philspins/Atom01_hardware/README_cn.md

# ROBOTO Open Source Hardware





[English](./README.md) | **[🇨🇳 中文](#chinese-version)**

---

## 🇨🇳 Project Overview (项目概览)

This project is the core hardware repository for the **ROBOTO Bipedal Robot**. We are committed to lowering the assembly threshold by providing a complete open-source solution from mechanical structure to core circuitry.

This repository contains the following three core modules. Click the links to view detailed documentation:

### 📂 Core Modules Index (核心模组索引)

| Module Name<br>模组名称 | Function Description<br>功能描述 | Key Features<br>关键特性 | Documentation<br>文档入口 |
| :--- | :--- | :--- | :--- |
| **🤖 Robot Body**<br>机器人本体<br>(Robot Mechanical) | Mechanical structure and assembly guide<br>机械结构与总装指南 | • Step-by-step assembly tutorial<br>保姆级装配教程<br>• URDF simulation files<br>URDF 仿真文件 | [View Docs<br>查看文档](./atom01_mechnaic/README_cn.md) |
| **⚡ Power Distribution Board**<br>电源分配板<br>(Power Distribution) | Core power supply hub<br>核心供电枢纽 | • 48V high voltage input<br>48V 高压输入<br>• XT30/XT60 interface<br>XT30/XT60 接口<br>• Centralized power architecture<br>集中式供电架构 | [View Docs<br>查看文档](./atom01_pcb/Roboto_Power/README_cn.md) |
| **📡 Communication Module**<br>通讯模块<br>(USB-to-CAN) | Signal conversion gateway<br>信号转换网关 | • USB to 4-channel CAN<br>USB 转 4路 CAN<br>• Linux dedicated<br>Linux 专用<br>• 120Ω terminal matching<br>120Ω 终端匹配 | [View Docs<br>查看文档](./atom01_pcb/Roboto_Usb2Can/README_cn.md) |
---
