philspins/Atom01_hardware/atom01_mechnaic/01_SW_Project/Foot_Sole_Rubber_Assembly.SLDASM

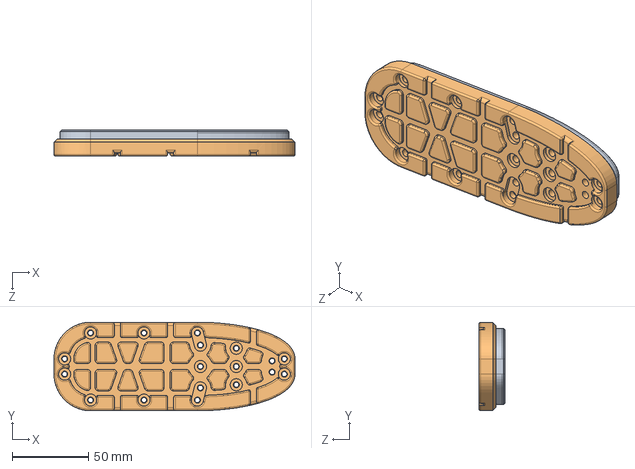
[picture p1: CAD file, 2026-02-06]
atom01_mechnaic/01_SW_Project/Foot_Sole_Rubber_Assembly.SLDASM
158.0 x 58.0 x 17.0 mm
脚底板
橡胶脚底
