philspins/Atom01_hardware/atom01_mechnaic/01_SW_Project/Foot_Assembly.SLDASM

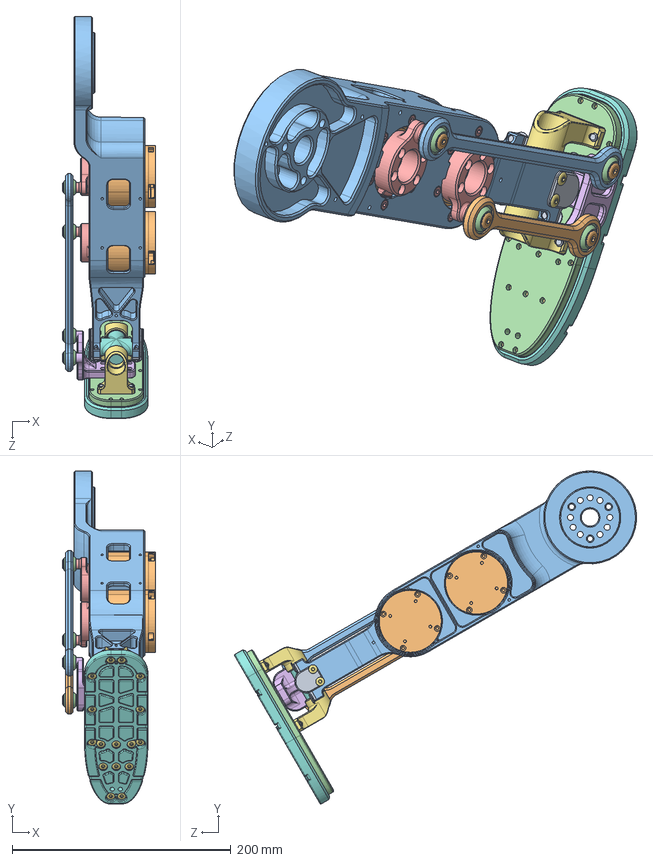
[picture p2: CAD file, 2026-02-06]
atom01_mechnaic/01_SW_Project/Foot_Assembly.SLDASM
85.0 x 304.7 x 367.8 mm
GB╱T 70.1-2008[内六角圆柱头螺钉M5×10].step x 10
短连杆
长连杆
镜向GB╱T 9163-2001[向心关节轴承（G系列）8] x 4
输出法兰连杆 x 2
脚底连杆
脚踝横滚连接件 x 2
镜向16x40十字轴承
小腿轴承锁 x 2
DM 4340 rau 3505 电机 3D x 2
小腿
脚底板
GB╱T 70.1-2008[内六角圆柱头螺钉M3×8].step x 12
GB╱T 70.1-2008[内六角圆柱头螺钉M3×12].step x 10
平头M4x10螺丝 x 20
橡胶脚底
平头M5x10螺丝 x 4
平头M5x16螺丝 x 4
