philspins/Atom01_hardware/atom01_mechnaic/01_SW_Project/GB_T_4605-2003[Thrust_Needle_Roller_and_Cage_Assembly_AXK6085].sldprt

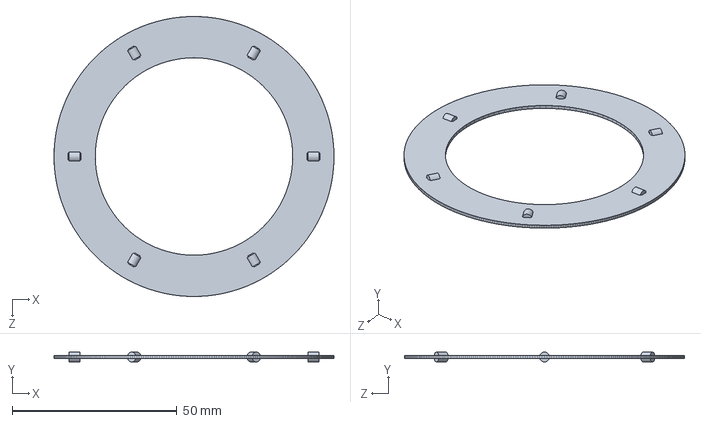
[picture p3: CAD file, 2026-02-06]
atom01_mechnaic/01_SW_Project/GB_T_4605-2003[Thrust_Needle_Roller_and_Cage_Assembly_AXK6085].sldprt
85.0 x 3.00 x 85.0 mm
