philspins/Atom01_hardware/atom01_mechnaic/01_SW_Project/01_Calibration_Parts/Foot_Calibration_Part_Qty1.STEP

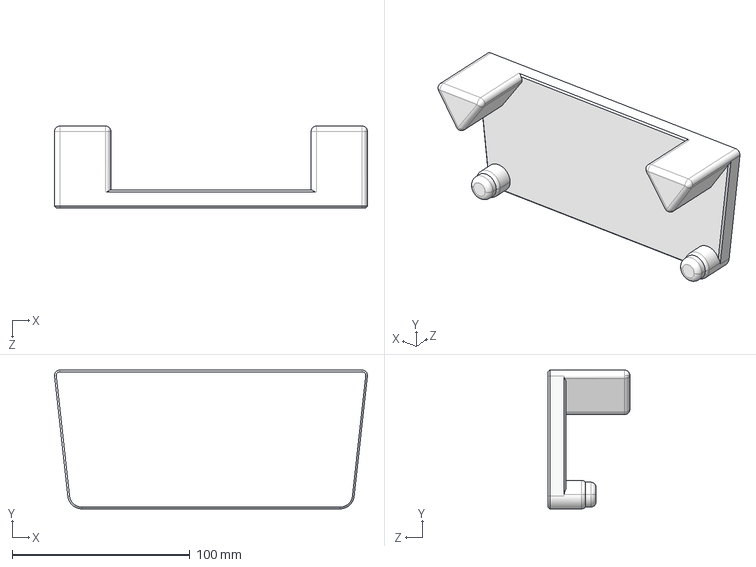
[picture p4: CAD file, 2026-02-06]
atom01_mechnaic/01_SW_Project/01_Calibration_Parts/Foot_Calibration_Part_Qty1.STEP
175.9 x 78.0 x 46.0 mm
