philspins/Atom01_hardware/atom01_mechnaic/01_SW_Project/20cm_Foot/20cm_Foot.STEP

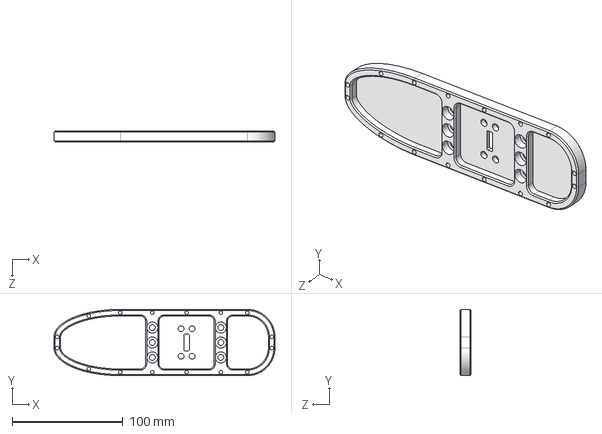
[picture p5: CAD file, 2026-02-06]
atom01_mechnaic/01_SW_Project/20cm_Foot/20cm_Foot.STEP
200.0 x 60.0 x 10.0 mm
