philspins/Atom01_hardware/atom01_mechnaic/01_SW_Project/Battery/Battery_Box_Rough_Dimensions.stp

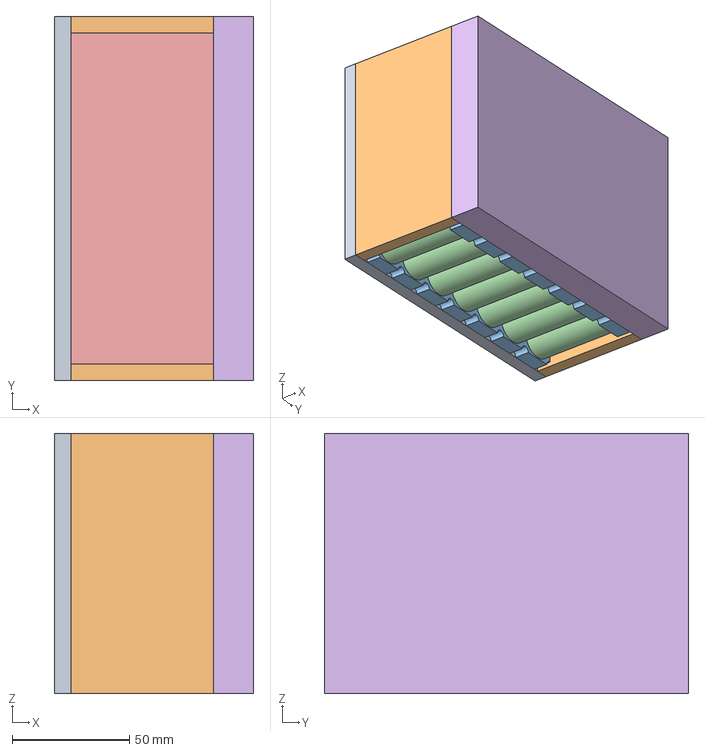
[picture p6: CAD file, 2026-02-06]
atom01_mechnaic/01_SW_Project/Battery/Battery_Box_Rough_Dimensions.stp
85.0 x 155.4 x 111.0 mm
