philspins/Atom01_hardware/atom01_mechnaic/01_SW_Project/Rubber_Foot_Sole/Rubber_Foot_Sole.STEP

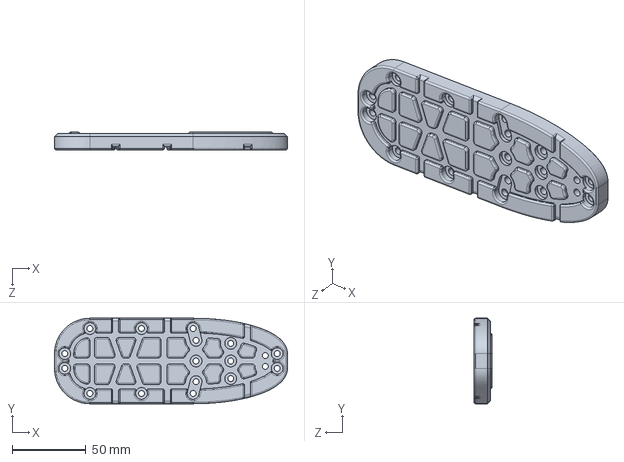
[picture p7: CAD file, 2026-02-06]
atom01_mechnaic/01_SW_Project/Rubber_Foot_Sole/Rubber_Foot_Sole.STEP
158.0 x 58.0 x 12.0 mm
