philspins/Atom01_hardware/atom01_mechnaic/01_SW_Project/Shell_Modified_Parts_1/Shell_Modified_Parts/Chest_Shoulder.stp

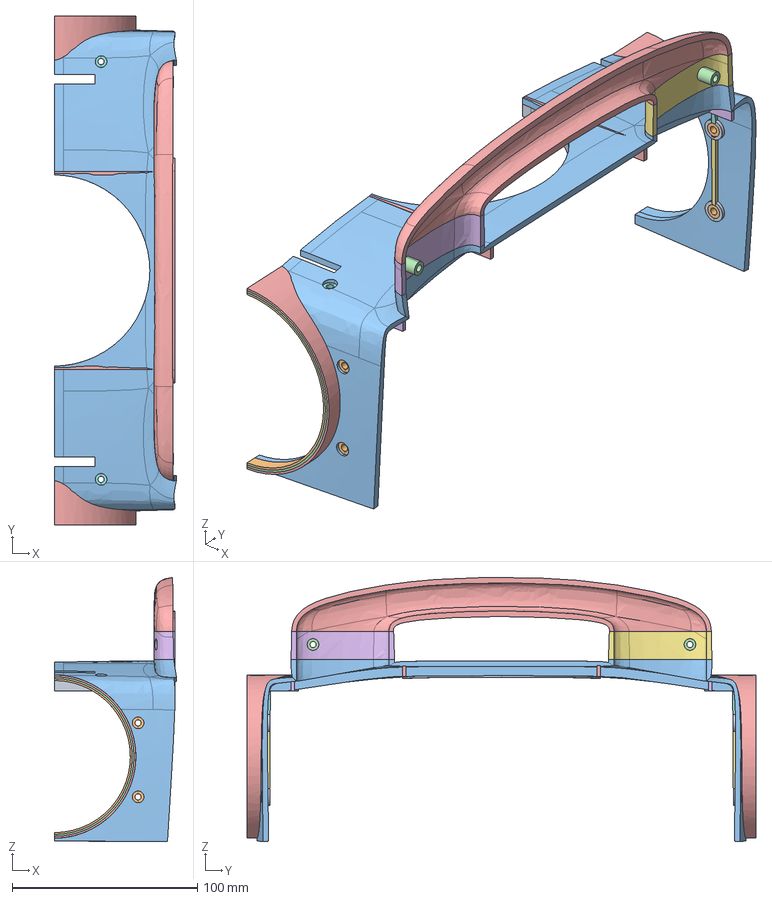
[picture p8: CAD file, 2026-02-06]
atom01_mechnaic/01_SW_Project/Shell_Modified_Parts_1/Shell_Modified_Parts/Chest_Shoulder.stp
66.2 x 275.1 x 142.7 mm
