philspins/Atom01_hardware/atom01_mechnaic/01_SW_Project/Shoulder_Mounting_Part.SLDPRT

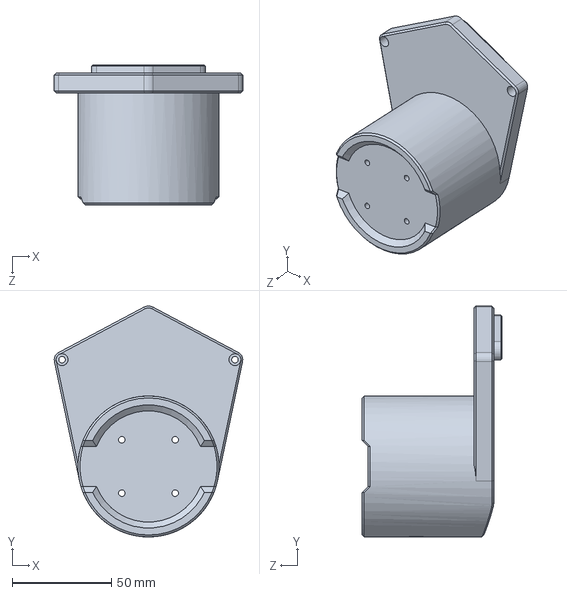
[picture p9: CAD file, 2026-02-06]
atom01_mechnaic/01_SW_Project/Shoulder_Mounting_Part.SLDPRT
95.0 x 116.3 x 70.2 mm
