philspins/Atom01_hardware/atom01_mechnaic/01_SW_Project/Soft_Rubber_Lower_Body/软胶 下身/Soft_Rubber_Lower_Leg_Rear_Left.stl

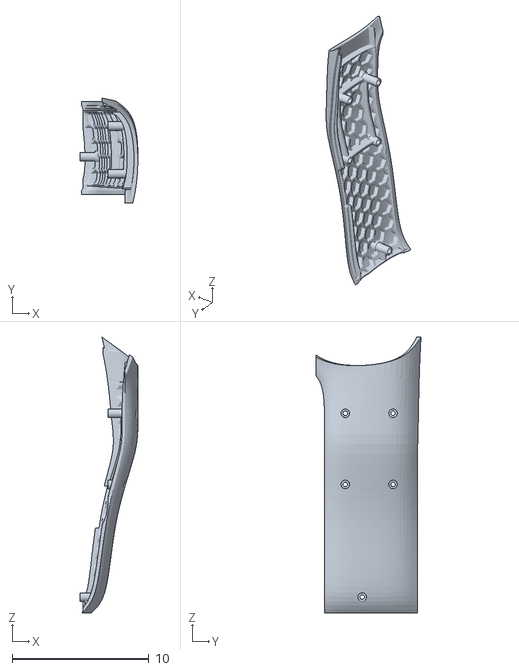
[picture p10: CAD file, 2026-02-06]
atom01_mechnaic/01_SW_Project/Soft_Rubber_Lower_Body/软胶 下身/Soft_Rubber_Lower_Leg_Rear_Left.stl
4.23 x 7.66 x 20.2
