philspins/Atom01_hardware/atom01_mechnaic/02_Manufacturing/3D_Printing/Waist_Calibration_Part_Qty1.STEP

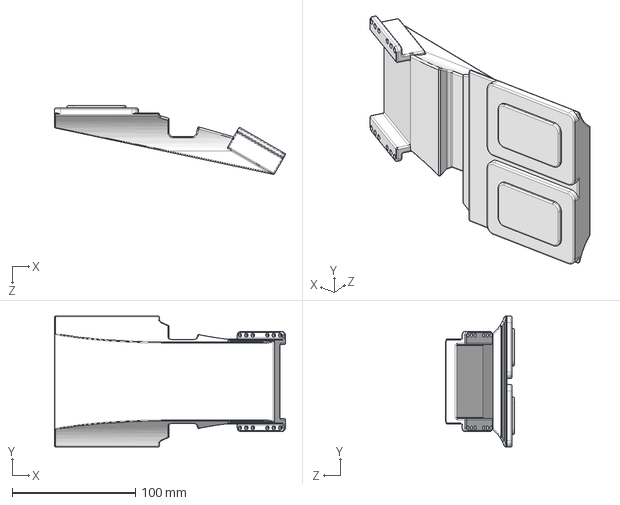
[picture p11: CAD file, 2026-02-06]
atom01_mechnaic/02_Manufacturing/3D_Printing/Waist_Calibration_Part_Qty1.STEP
187.2 x 106.0 x 55.7 mm
