philspins/Atom01_hardware/atom01_mechnaic/02_Manufacturing/CNC_Machining/Hip_Clamp_Plate.STEP

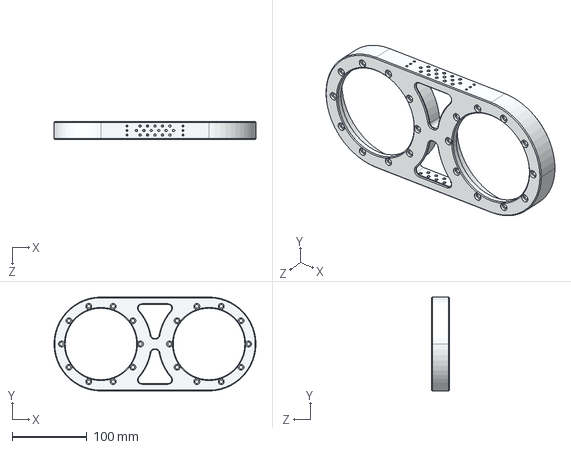
[picture p12: CAD file, 2026-02-06]
atom01_mechnaic/02_Manufacturing/CNC_Machining/Hip_Clamp_Plate.STEP
271.0 x 126.0 x 24.0 mm
