philspins/Atom01_hardware/atom01_mechnaic/atom-bom/SW模型/外壳修改部件(1)/外壳修改部件/腰部下册.stp

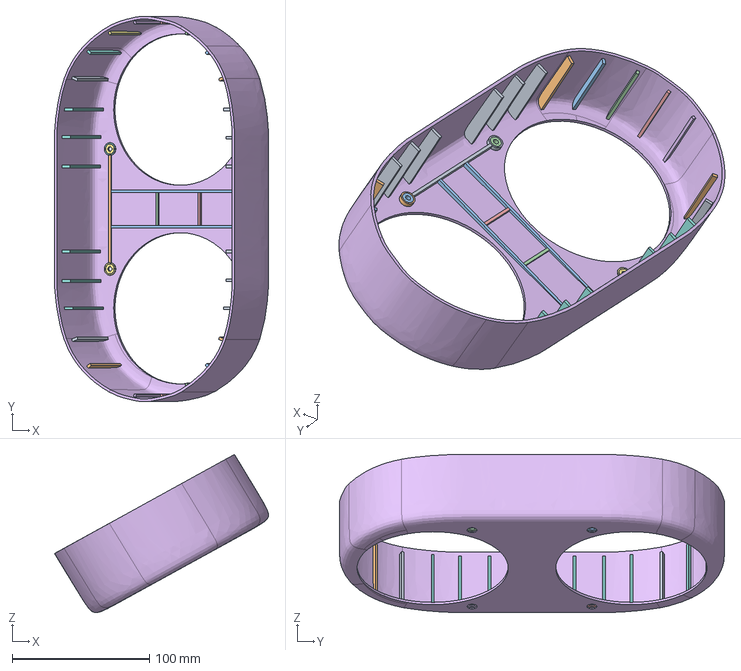
[picture p13: CAD file, 2025-05-23]
atom01_mechnaic/atom-bom/SW模型/外壳修改部件(1)/外壳修改部件/腰部下册.stp
156.1 x 281.2 x 115.4 mm
