philspins/Atom01_hardware/atom01_mechnaic/atom-bom/SW模型/通用连接件扩孔法兰.SLDPRT

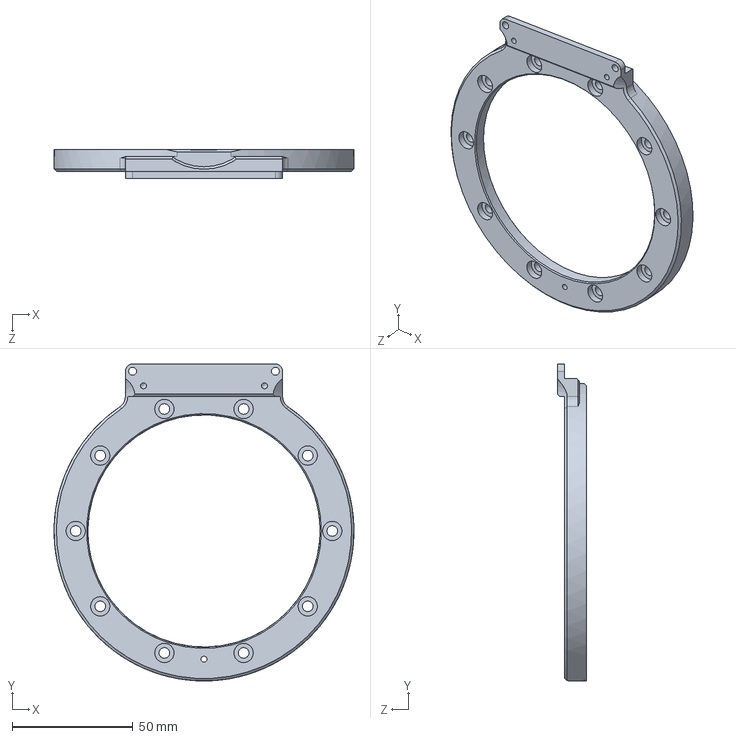
[picture p14: CAD file, 2025-05-23]
atom01_mechnaic/atom-bom/SW模型/通用连接件扩孔法兰.SLDPRT
123.9 x 131.0 x 12.0 mm
