philspins/Atom01_hardware/atom01_mechnaic/01_SW_Project/01_Calibration_Parts/Thigh_Rear_Calibration_Qty1.STEP

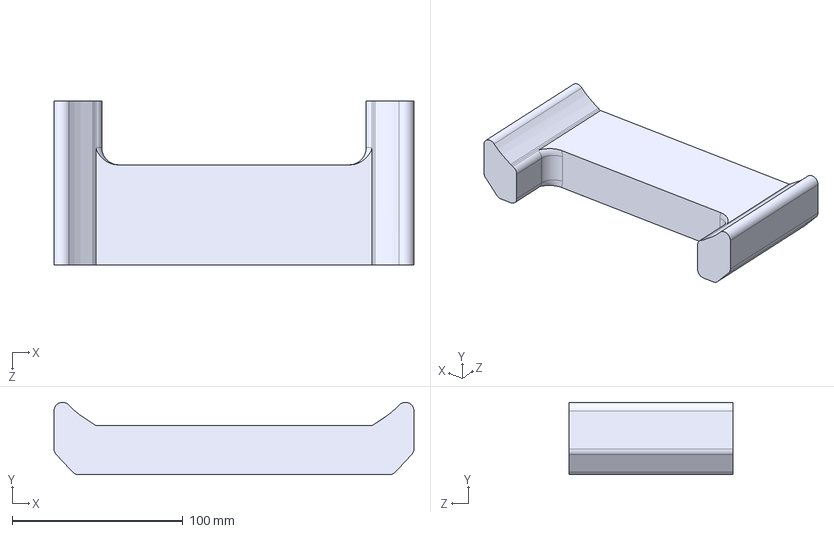
[picture p16: CAD file, 2026-02-06]
atom01_mechnaic/01_SW_Project/01_Calibration_Parts/Thigh_Rear_Calibration_Qty1.STEP
210.7 x 42.4 x 96.0 mm
