philspins/Atom01_hardware/atom01_mechnaic/01_SW_Project/Long_Link.STEP

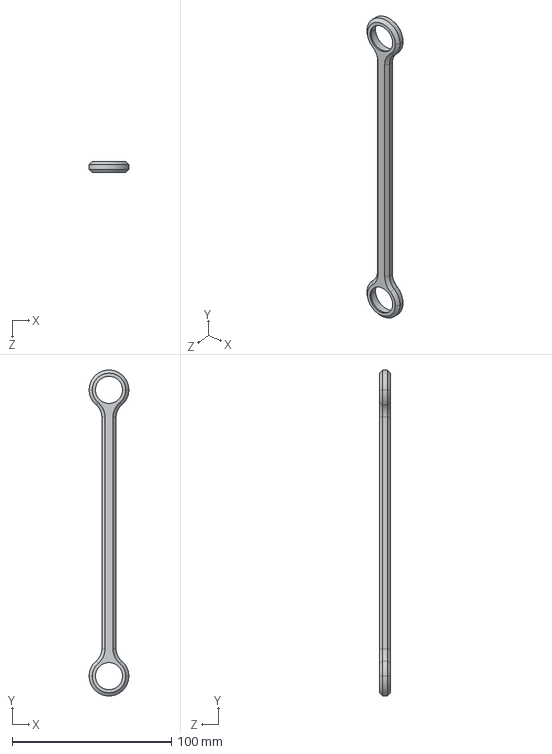
[picture p17: CAD file, 2026-02-06]
atom01_mechnaic/01_SW_Project/Long_Link.STEP
25.0 x 205.0 x 7.00 mm
