philspins/Atom01_hardware/atom01_mechnaic/01_SW_Project/Shell_Modified_Parts_1/Shell_Modified_Parts/Thigh_Root_Structure_Hole.stp

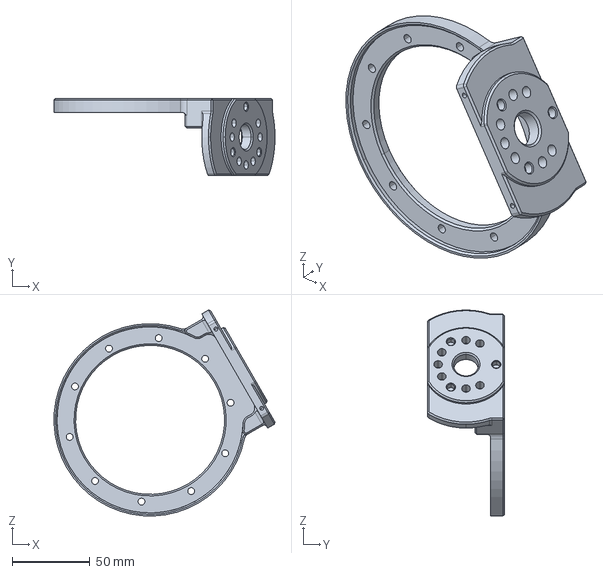
[picture p18: CAD file, 2026-02-06]
atom01_mechnaic/01_SW_Project/Shell_Modified_Parts_1/Shell_Modified_Parts/Thigh_Root_Structure_Hole.stp
142.5 x 49.7 x 132.8 mm
