philspins/Atom01_hardware/atom01_mechnaic/01_SW_Project/Soft_Rubber_Lower_Body/软胶 下身/Soft_Rubber_Thigh_Root_Left.stl

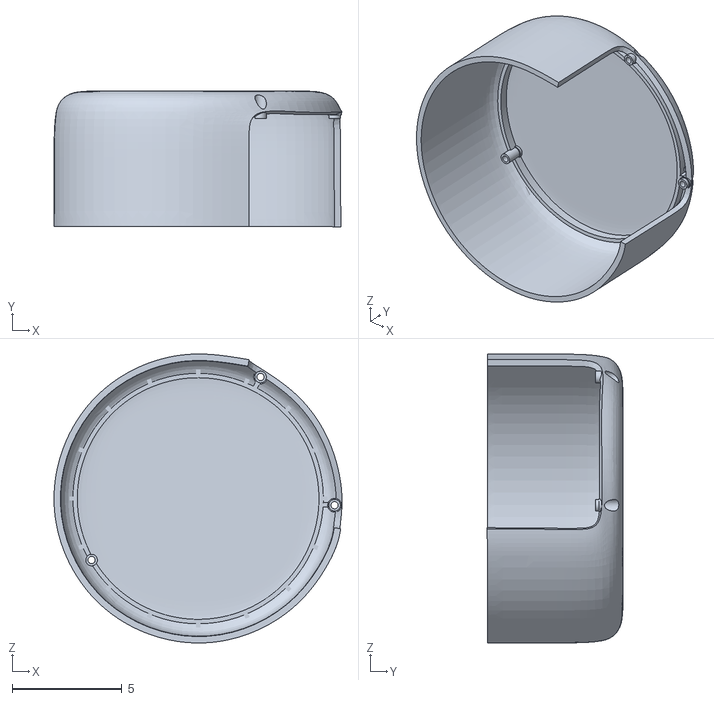
[picture p19: CAD file, 2026-02-06]
atom01_mechnaic/01_SW_Project/Soft_Rubber_Lower_Body/软胶 下身/Soft_Rubber_Thigh_Root_Left.stl
13.1 x 6.21 x 13.2
