philspins/Atom01_hardware/atom01_mechnaic/02_Manufacturing/3D_Printing/Thigh_Positioning_Block_Qty2.STEP

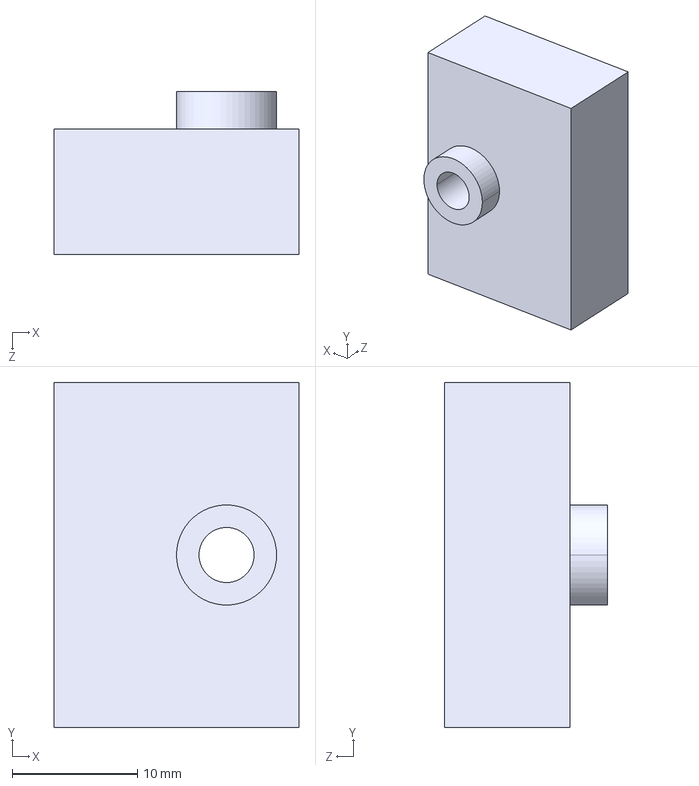
[picture p20: CAD file, 2026-02-06]
atom01_mechnaic/02_Manufacturing/3D_Printing/Thigh_Positioning_Block_Qty2.STEP
19.6 x 27.6 x 13.0 mm
