philspins/Atom01_hardware/atom01_mechnaic/02_Manufacturing/CNC_Machining/Hip_Joint_Mounting.STEP

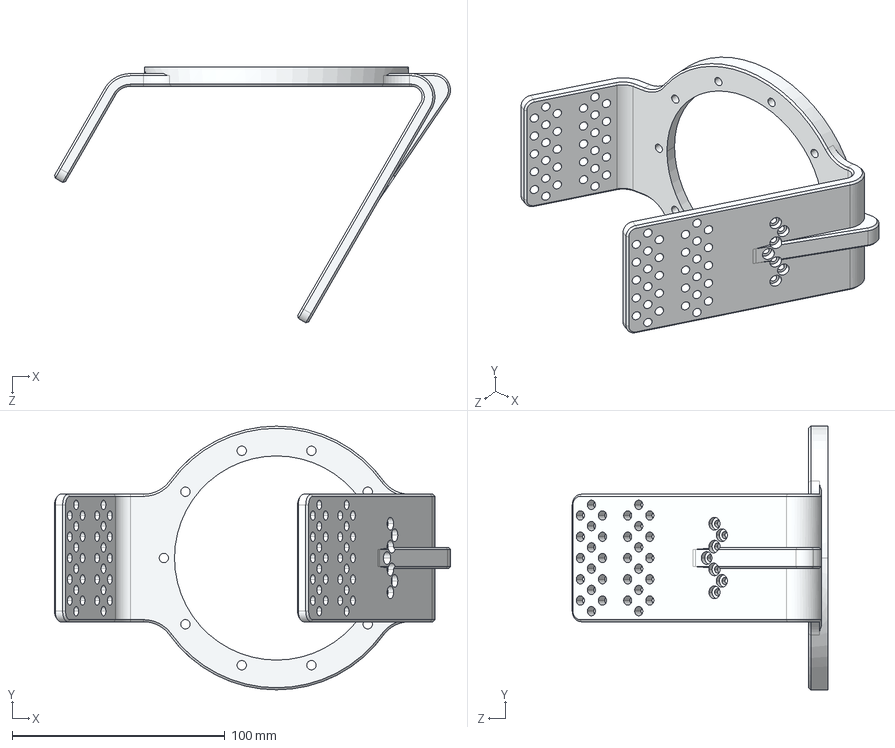
[picture p21: CAD file, 2026-02-06]
atom01_mechnaic/02_Manufacturing/CNC_Machining/Hip_Joint_Mounting.STEP
186.2 x 124.0 x 120.2 mm
