philspins/Atom01_hardware/atom01_mechnaic/atom-bom/SW模型/通用连接件.SLDPRT

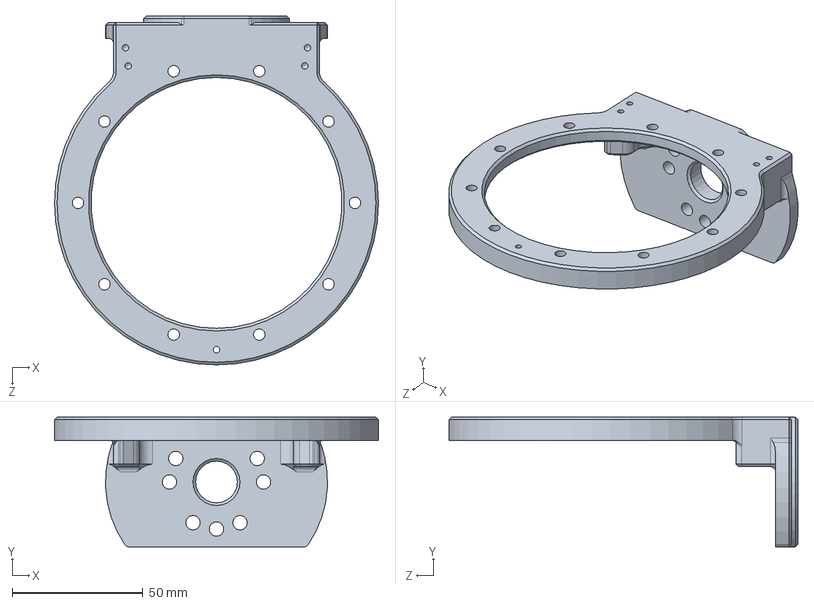
[picture p22: CAD file, 2025-05-23]
atom01_mechnaic/atom-bom/SW模型/通用连接件.SLDPRT
124.0 x 49.7 x 133.5 mm
