philspins/Atom01_hardware/atom01_mechnaic/01_SW_Project/Lower_Leg_Bearing_Lock.STEP

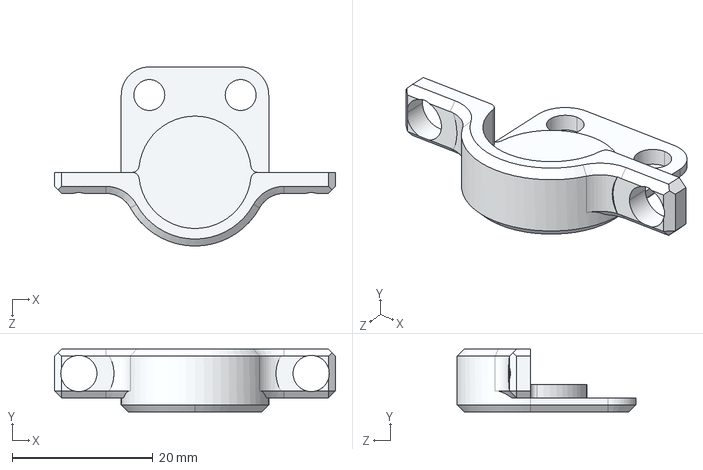
[picture p23: CAD file, 2026-02-06]
atom01_mechnaic/01_SW_Project/Lower_Leg_Bearing_Lock.STEP
40.0 x 8.93 x 25.5 mm
