philspins/Atom01_hardware/atom01_mechnaic/01_SW_Project/Soft_Rubber_Lower_Body/软胶 下身/Soft_Rubber_Waist_Lower.stl

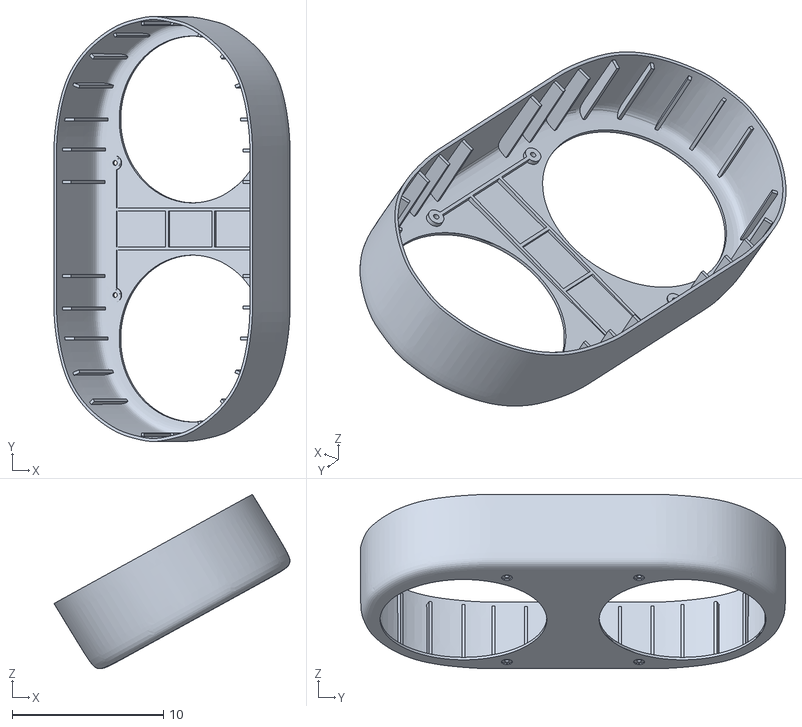
[picture p24: CAD file, 2026-02-06]
atom01_mechnaic/01_SW_Project/Soft_Rubber_Lower_Body/软胶 下身/Soft_Rubber_Waist_Lower.stl
15.6 x 28.1 x 11.5
