philspins/Atom01_hardware/atom01_mechnaic/02_Manufacturing/3D_Printing/PCB_Carrier_Board.STEP

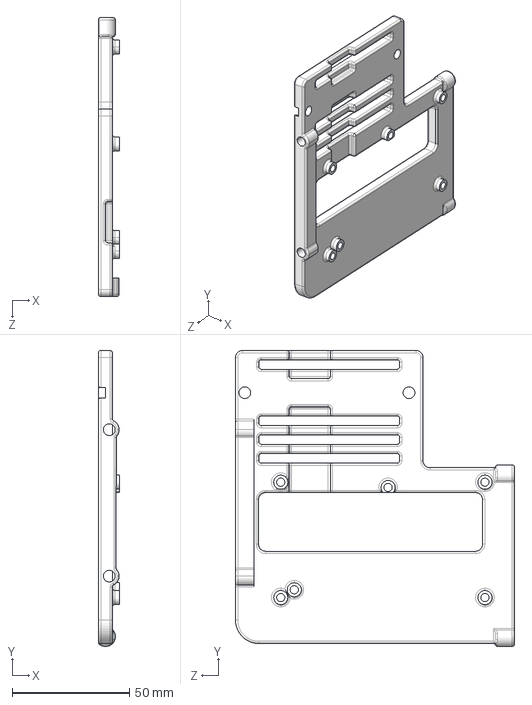
[picture p25: CAD file, 2026-02-06]
atom01_mechnaic/02_Manufacturing/3D_Printing/PCB_Carrier_Board.STEP
9.00 x 126.2 x 119.0 mm
