philspins/Atom01_hardware/atom01_mechnaic/02_Manufacturing/CNC_Machining/atom_arm_copy_3.STEP

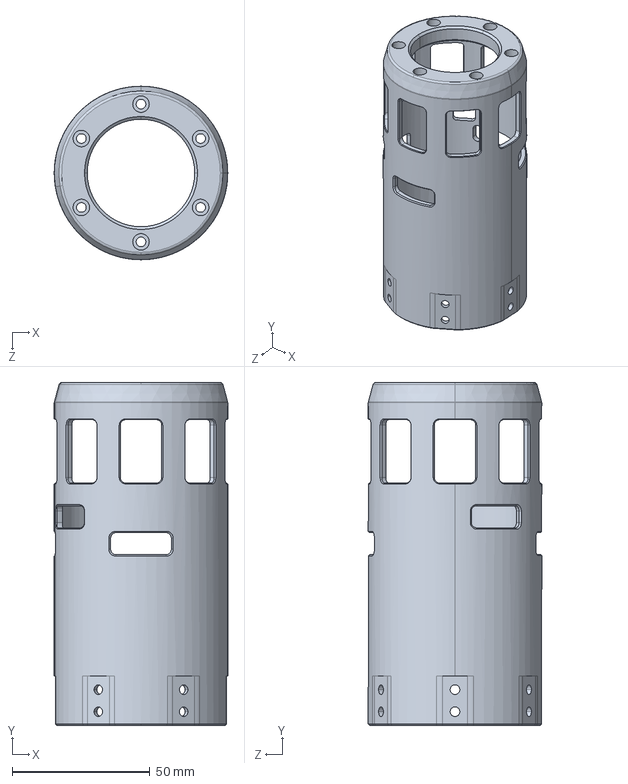
[picture p26: CAD file, 2026-02-06]
atom01_mechnaic/02_Manufacturing/CNC_Machining/atom_arm_copy_3.STEP
63.0 x 124.5 x 63.0 mm
