philspins/Atom01_hardware/atom01_mechnaic/atom-bom/SW模型/髋夹板.SLDPRT

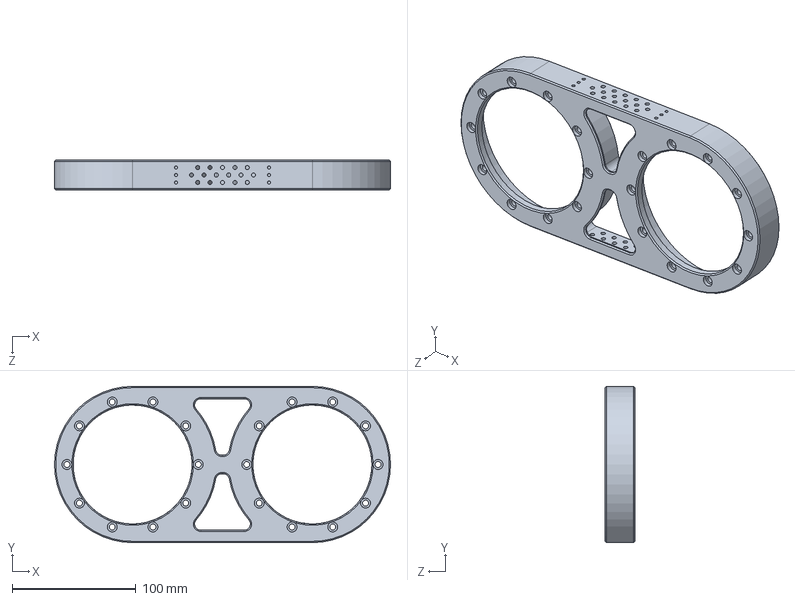
[picture p27: CAD file, 2025-05-23]
atom01_mechnaic/atom-bom/SW模型/髋夹板.SLDPRT
271.0 x 126.0 x 24.0 mm
