philspins/Atom01_hardware/atom01_mechnaic/01_SW_Project/Soft_Rubber_Lower_Body/软胶 下身/Soft_Rubber_Lower_Leg_Knee_Left.stl

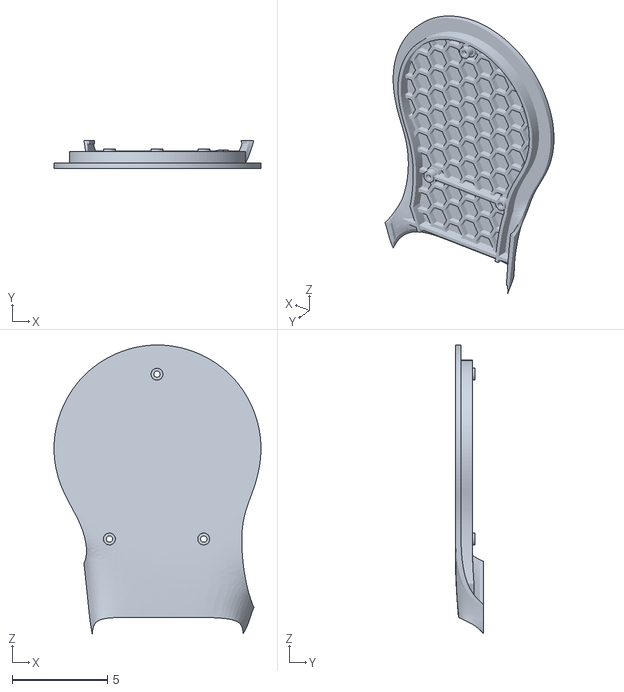
[picture p28: CAD file, 2026-02-06]
atom01_mechnaic/01_SW_Project/Soft_Rubber_Lower_Body/软胶 下身/Soft_Rubber_Lower_Leg_Knee_Left.stl
10.9 x 1.49 x 15.2
