philspins/Atom01_hardware/atom01_mechnaic/02_Manufacturing/3D_Printing/Knee_Calibration_Qty2.STEP

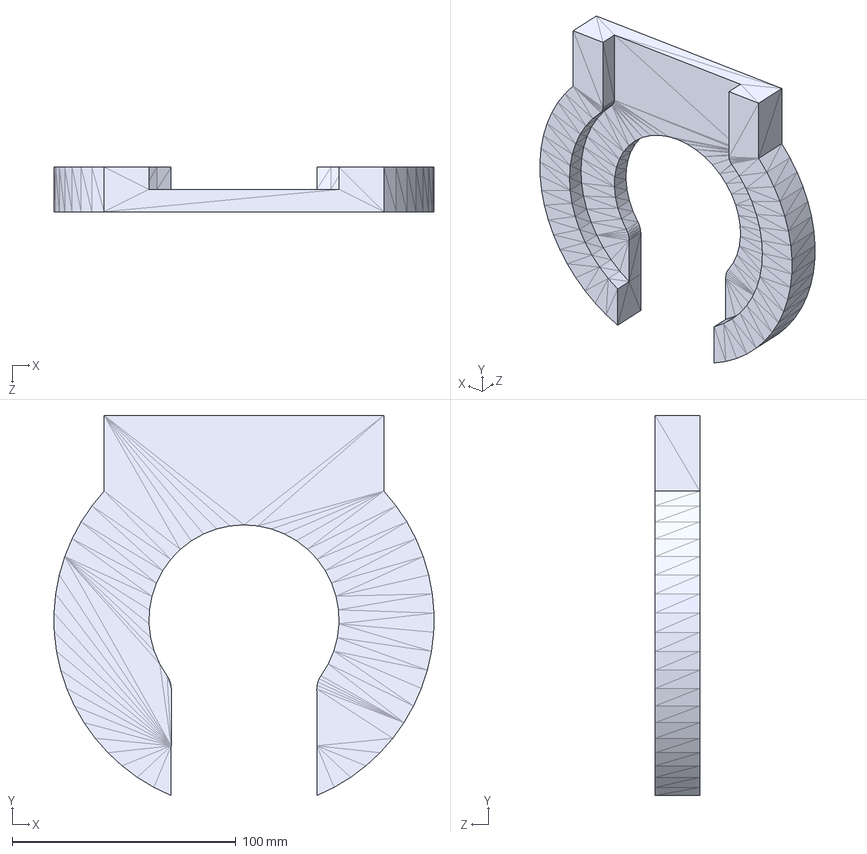
[picture p29: CAD file, 2026-02-06]
atom01_mechnaic/02_Manufacturing/3D_Printing/Knee_Calibration_Qty2.STEP
169.9 x 170.0 x 19.9 mm
