philspins/Atom01_hardware/atom01_mechnaic/02_Manufacturing/CNC_Machining/IMU_Carrier_Board.STEP

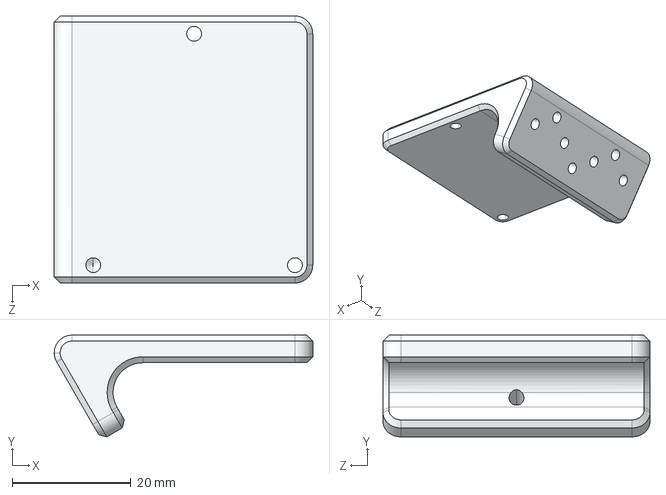
[picture p30: CAD file, 2026-02-06]
atom01_mechnaic/02_Manufacturing/CNC_Machining/IMU_Carrier_Board.STEP
43.6 x 17.1 x 45.0 mm
