philspins/Atom01_hardware/atom01_mechnaic/01_SW_Project/Soft_Rubber_Lower_Body/软胶 下身/Soft_Rubber_Thigh_Rear_Left.stl

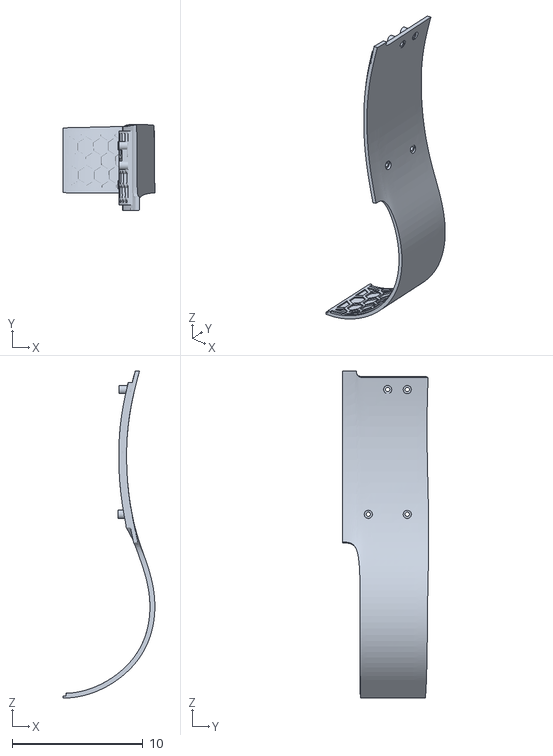
[picture p31: CAD file, 2026-02-06]
atom01_mechnaic/01_SW_Project/Soft_Rubber_Lower_Body/软胶 下身/Soft_Rubber_Thigh_Rear_Left.stl
7.01 x 6.61 x 25.0
