philspins/Atom01_hardware/atom01_mechnaic/01_SW_Project/Upper_Arm_Root_Front.stp

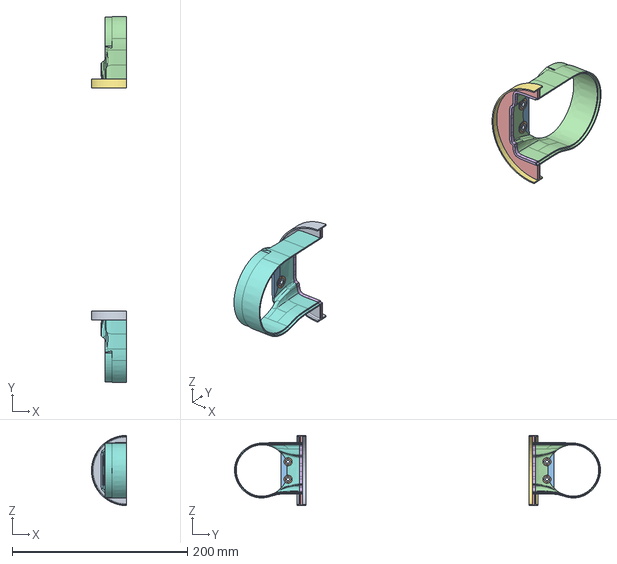
[picture p32: CAD file, 2026-02-06]
atom01_mechnaic/01_SW_Project/Upper_Arm_Root_Front.stp
40.1 x 417.7 x 80.2 mm
