philspins/Atom01_hardware/atom01_mechnaic/02_Manufacturing/3D_Printing/Ankle_Calibration_Qty2.STEP

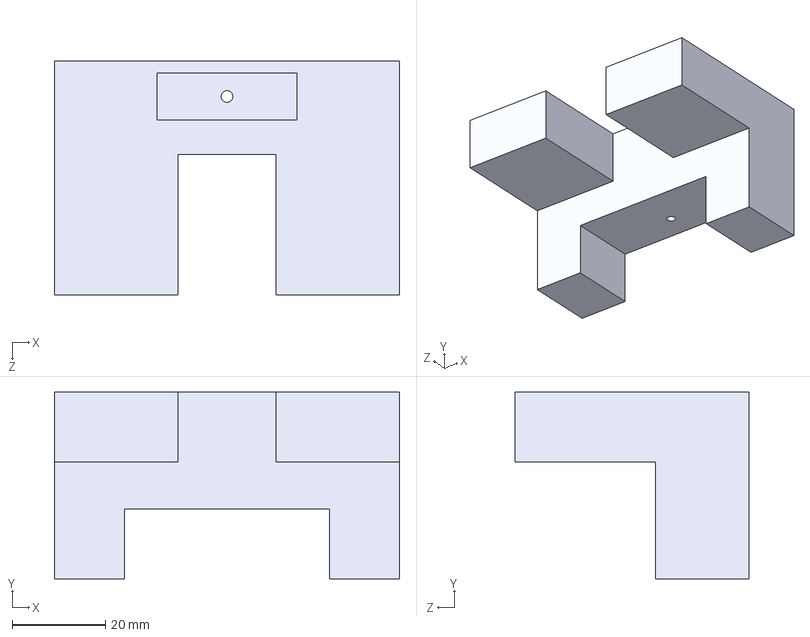
[picture p35: CAD file, 2026-02-06]
atom01_mechnaic/02_Manufacturing/3D_Printing/Ankle_Calibration_Qty2.STEP
73.9 x 40.0 x 50.0 mm
