philspins/Atom01_hardware/atom01_mechnaic/02_Manufacturing/CNC_Machining/atom_arm_copy_4.STEP

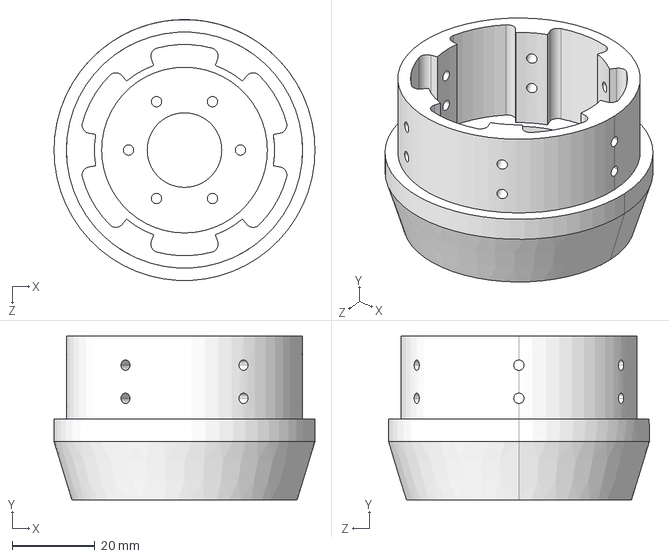
[picture p36: CAD file, 2026-02-06]
atom01_mechnaic/02_Manufacturing/CNC_Machining/atom_arm_copy_4.STEP
63.0 x 39.5 x 63.0 mm
