philspins/Atom01_hardware/atom01_mechnaic/01_SW_Project/Chest_Rear_Clamp_Plate.STEP

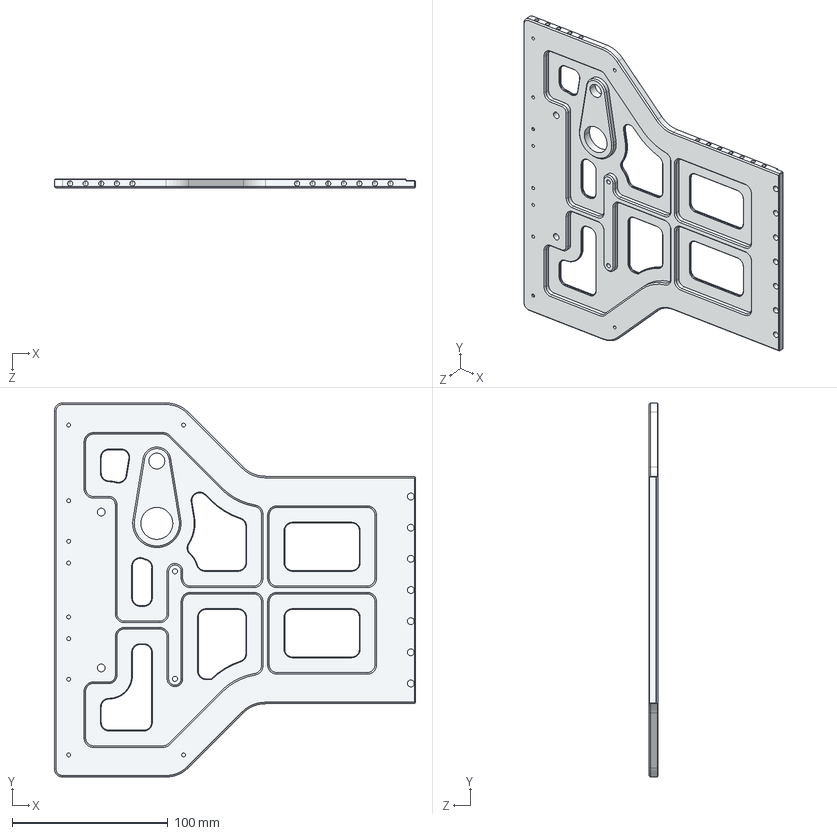
[picture p37: CAD file, 2026-02-06]
atom01_mechnaic/01_SW_Project/Chest_Rear_Clamp_Plate.STEP
231.7 x 240.0 x 6.00 mm
