philspins/Atom01_hardware/atom01_mechnaic/02_Manufacturing/CNC_Machining/Ankle_Roll_Connector.STEP

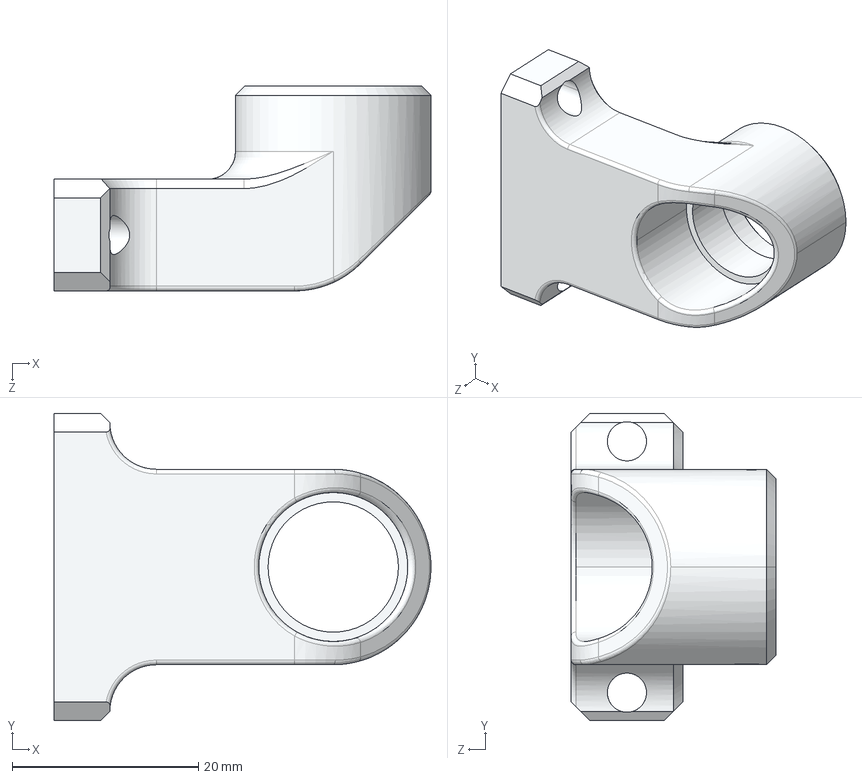
[picture p39: CAD file, 2026-02-06]
atom01_mechnaic/02_Manufacturing/CNC_Machining/Ankle_Roll_Connector.STEP
40.5 x 33.0 x 22.0 mm
