philspins/Atom01_hardware/atom01_mechnaic/01_SW_Project/01_Calibration_Parts/Elbow_Calibration_Part_Qty2.STEP

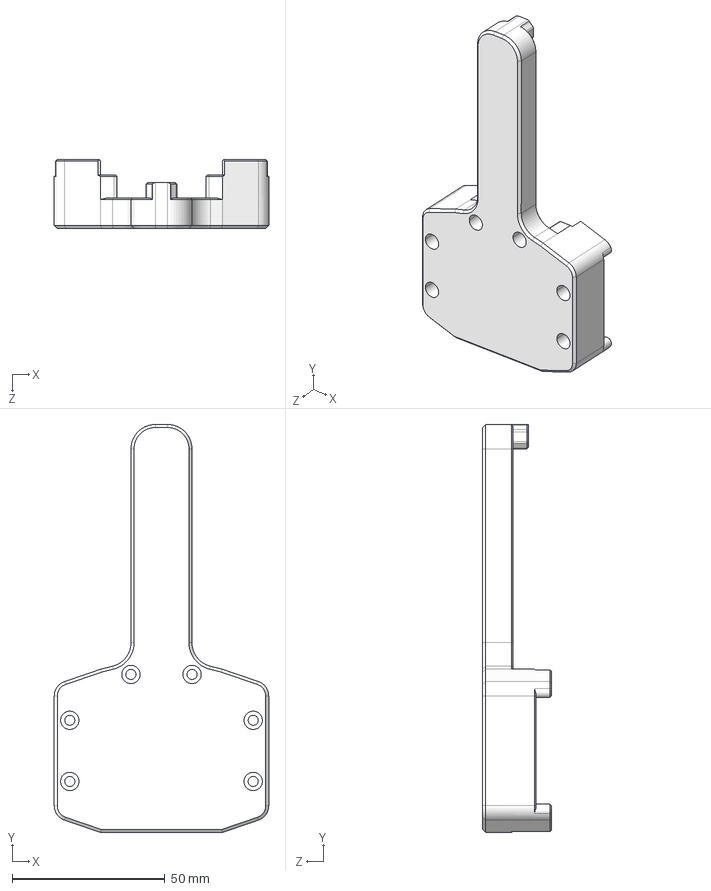
[picture p40: CAD file, 2026-02-06]
atom01_mechnaic/01_SW_Project/01_Calibration_Parts/Elbow_Calibration_Part_Qty2.STEP
70.2 x 133.4 x 22.6 mm
