philspins/Atom01_hardware/atom01_mechnaic/02_Manufacturing/CNC_Machining/Foot_Sole_Plate.STEP

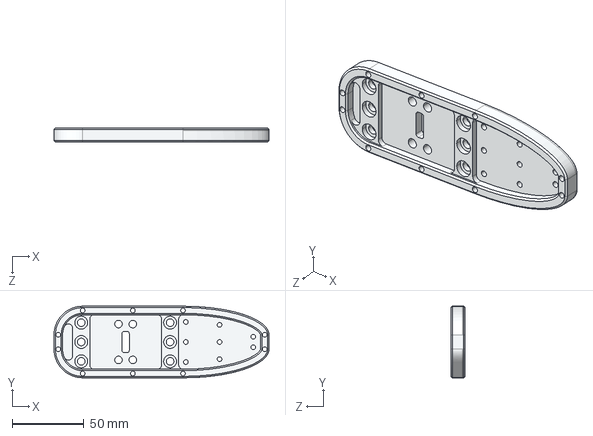
[picture p43: CAD file, 2026-02-06]
atom01_mechnaic/02_Manufacturing/CNC_Machining/Foot_Sole_Plate.STEP
150.0 x 50.0 x 10.0 mm
