philspins/Atom01_hardware/atom01_mechnaic/01_SW_Project/Right_Hand.SLDPRT

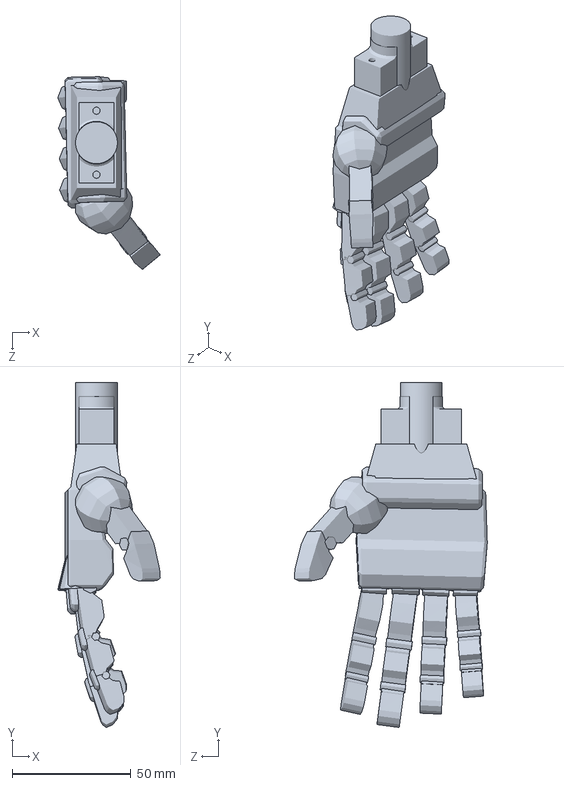
[picture p45: CAD file, 2026-02-06]
atom01_mechnaic/01_SW_Project/Right_Hand.SLDPRT
43.2 x 145.5 x 81.3 mm
