philspins/Atom01_hardware/atom01_mechnaic/02_Manufacturing/CNC_Machining/Waist_Support.STEP

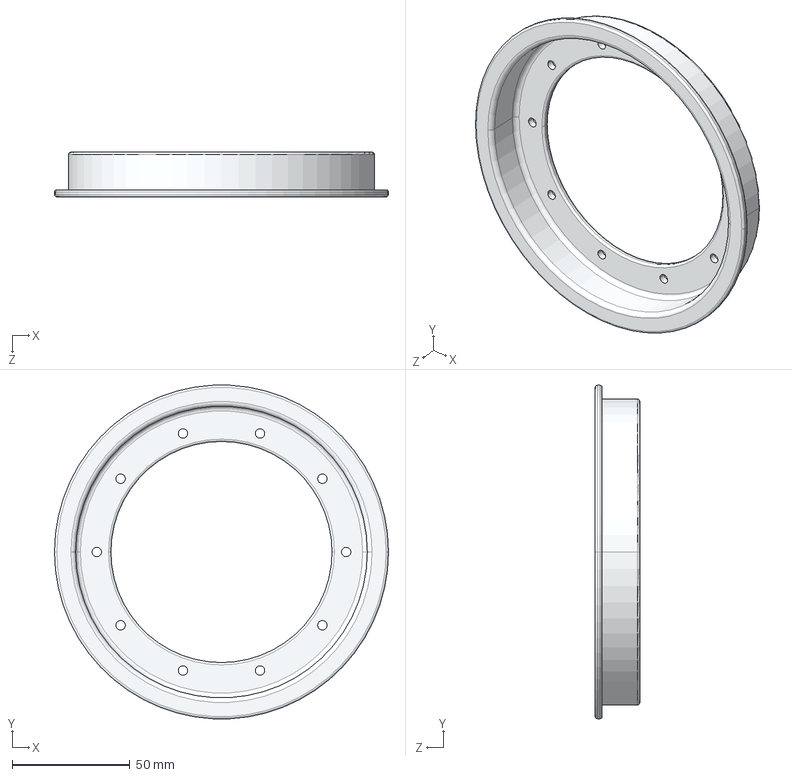
[picture p46: CAD file, 2026-02-06]
atom01_mechnaic/02_Manufacturing/CNC_Machining/Waist_Support.STEP
142.0 x 141.8 x 19.0 mm
