philspins/Atom01_hardware/atom01_mechnaic/01_SW_Project/48V_to_5V.SLDPRT

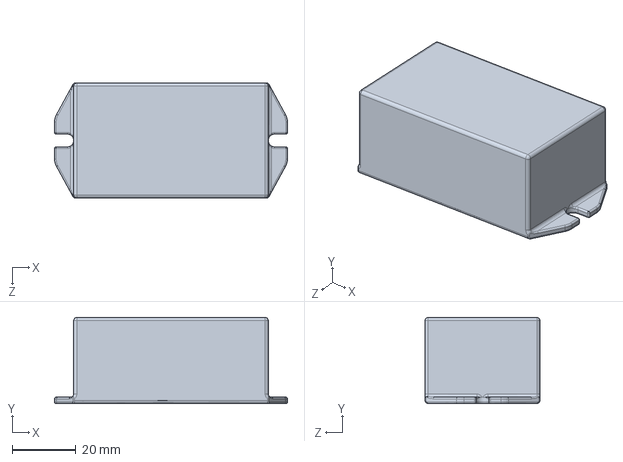
[picture p47: CAD file, 2026-02-06]
atom01_mechnaic/01_SW_Project/48V_to_5V.SLDPRT
73.0 x 27.0 x 36.0 mm
