philspins/Atom01_hardware/atom01_mechnaic/02_Manufacturing/CNC_Machining/atom_arm_copy_2.STEP

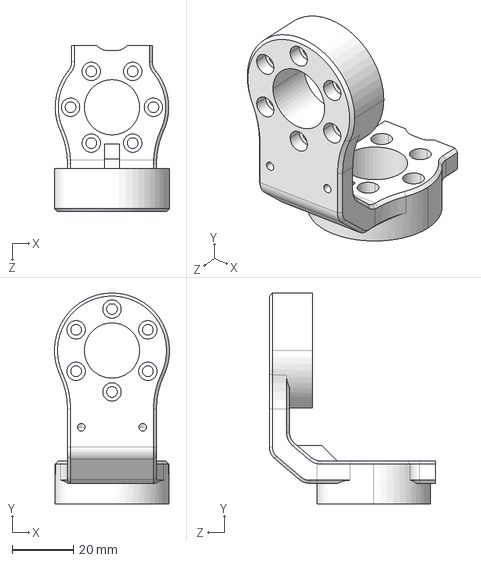
[picture p48: CAD file, 2026-02-06]
atom01_mechnaic/02_Manufacturing/CNC_Machining/atom_arm_copy_2.STEP
37.5 x 68.7 x 54.2 mm
