philspins/Atom01_hardware/atom01_mechnaic/02_Manufacturing/CNC_Machining/Limit_Pin.STEP

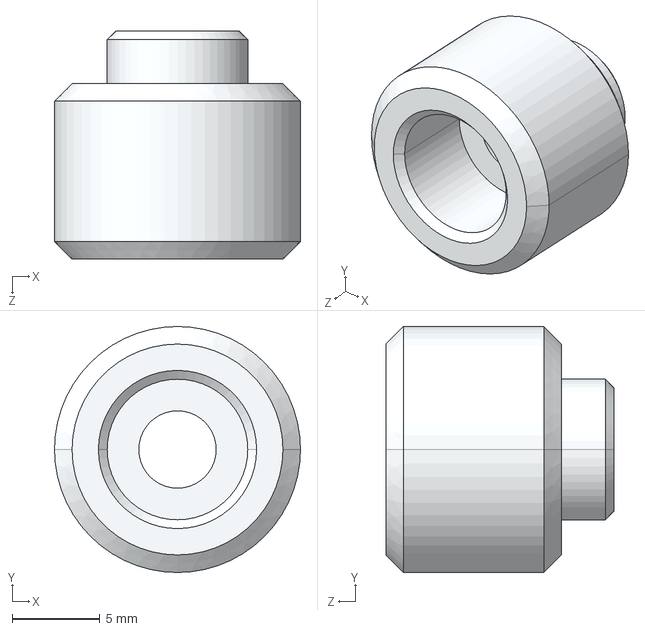
[picture p50: CAD file, 2026-02-06]
atom01_mechnaic/02_Manufacturing/CNC_Machining/Limit_Pin.STEP
14.0 x 14.0 x 13.0 mm
