philspins/Atom01_hardware/atom01_mechnaic/02_Manufacturing/CNC_Machining/Side_Plate_Cross_Plate.STEP

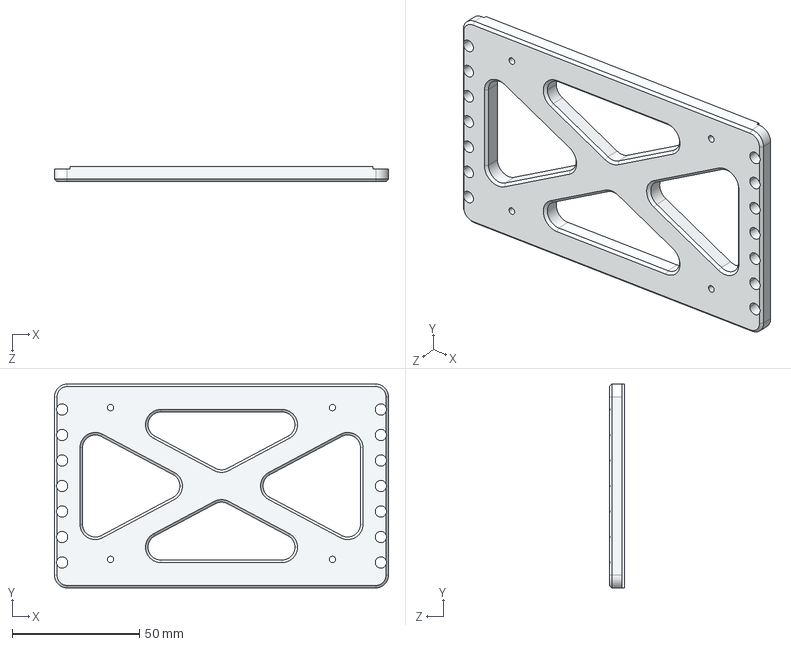
[picture p51: CAD file, 2026-02-06]
atom01_mechnaic/02_Manufacturing/CNC_Machining/Side_Plate_Cross_Plate.STEP
131.0 x 80.0 x 6.00 mm
