philspins/Atom01_hardware/atom01_mechnaic/01_SW_Project/Hand_Spherical.stp

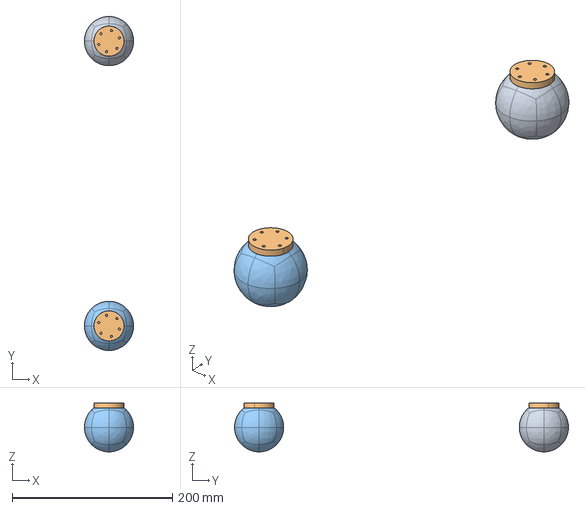
[picture p52: CAD file, 2026-02-06]
atom01_mechnaic/01_SW_Project/Hand_Spherical.stp
61.4 x 416.9 x 60.9 mm
