philspins/Atom01_hardware/atom01_mechnaic/01_SW_Project/PCB_Carrier_Board.STEP

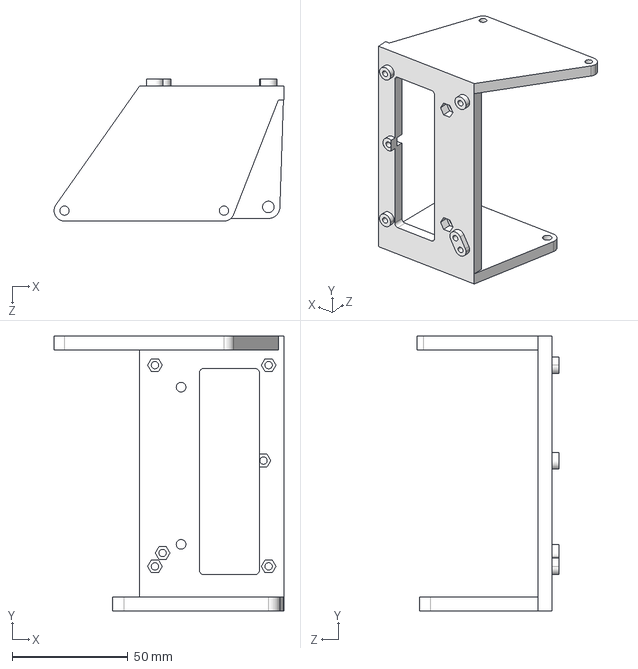
[picture p54: CAD file, 2026-02-06]
atom01_mechnaic/01_SW_Project/PCB_Carrier_Board.STEP
99.4 x 119.0 x 61.5 mm
