philspins/Atom01_hardware/atom01_mechnaic/01_SW_Project/Upper_Arm_Root_Rear.stp

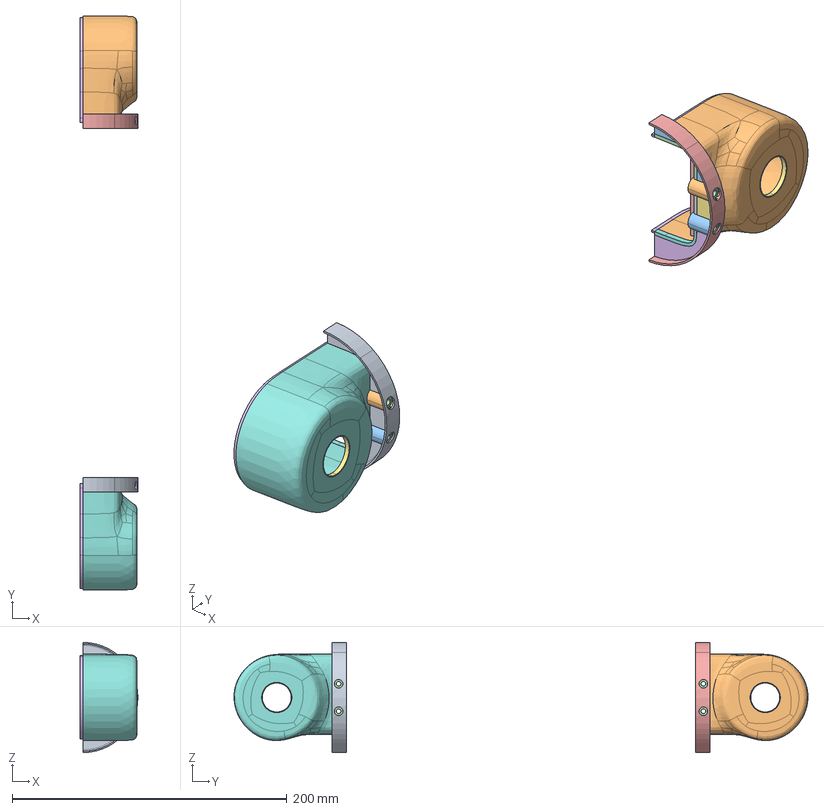
[picture p55: CAD file, 2026-02-06]
atom01_mechnaic/01_SW_Project/Upper_Arm_Root_Rear.stp
42.1 x 417.7 x 80.2 mm
