philspins/Atom01_hardware/atom01_mechnaic/02_Manufacturing/CNC_Machining/Lower_Leg.STEP

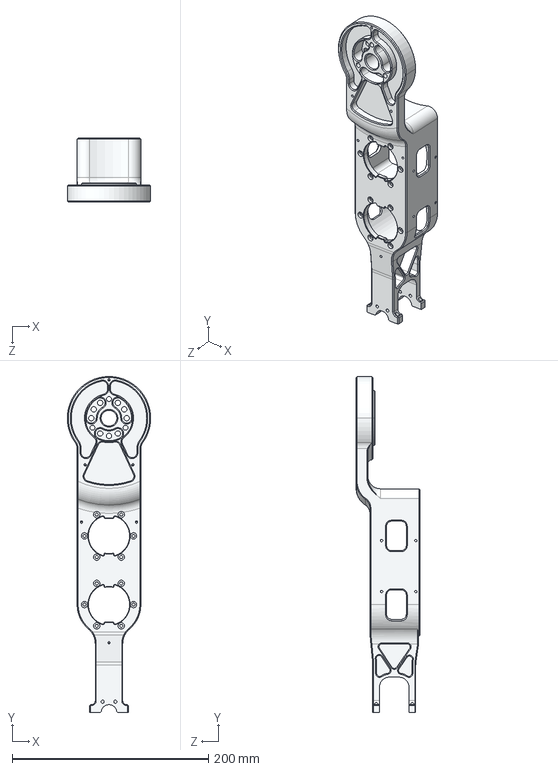
[picture p56: CAD file, 2026-02-06]
atom01_mechnaic/02_Manufacturing/CNC_Machining/Lower_Leg.STEP
85.0 x 342.5 x 65.0 mm
