philspins/Atom01_hardware/atom01_mechnaic/02_Manufacturing/CNC_Machining/atom_arm_copy_1.STEP

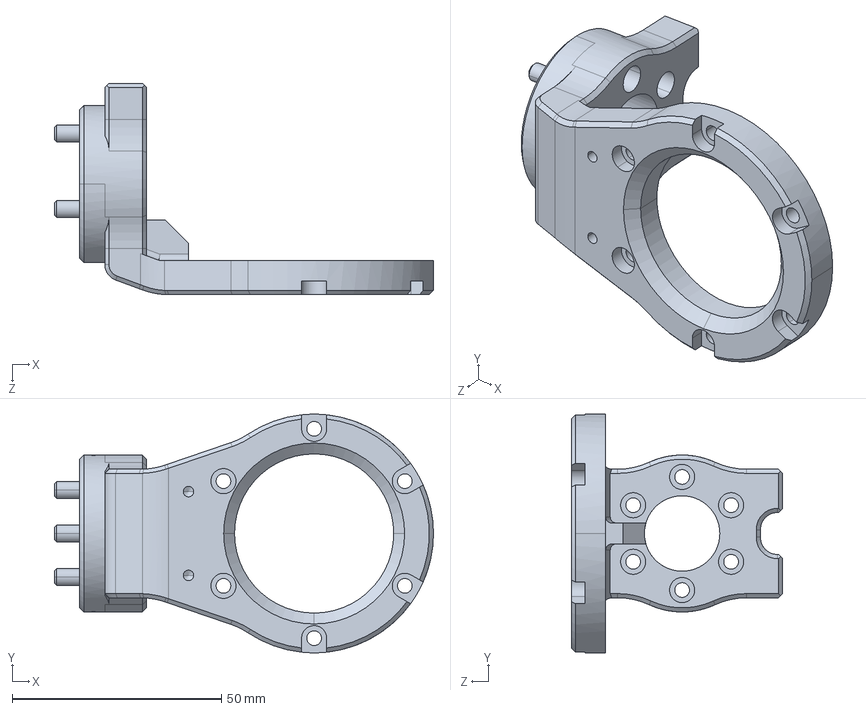
[picture p57: CAD file, 2026-02-06]
atom01_mechnaic/02_Manufacturing/CNC_Machining/atom_arm_copy_1.STEP
90.5 x 57.0 x 50.5 mm
