philspins/Atom01_hardware/atom01_mechnaic/01_SW_Project/Handle.stp

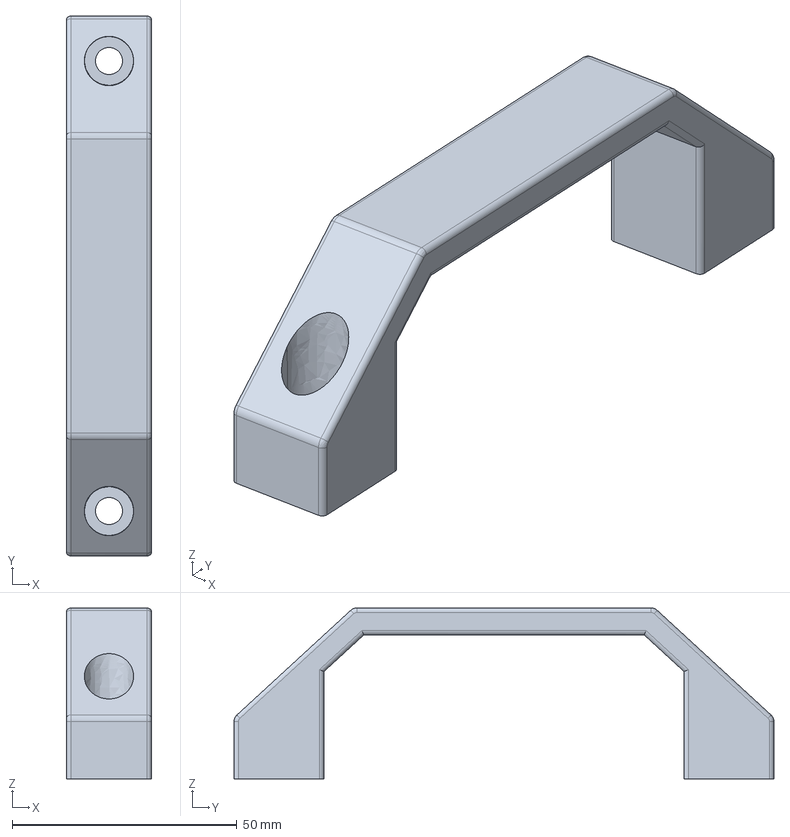
[picture p58: CAD file, 2026-02-06]
atom01_mechnaic/01_SW_Project/Handle.stp
19.0 x 120.0 x 38.0 mm
