philspins/Atom01_hardware/atom01_mechnaic/02_Manufacturing/CNC_Machining/Battery_Bottom_Cover.STEP

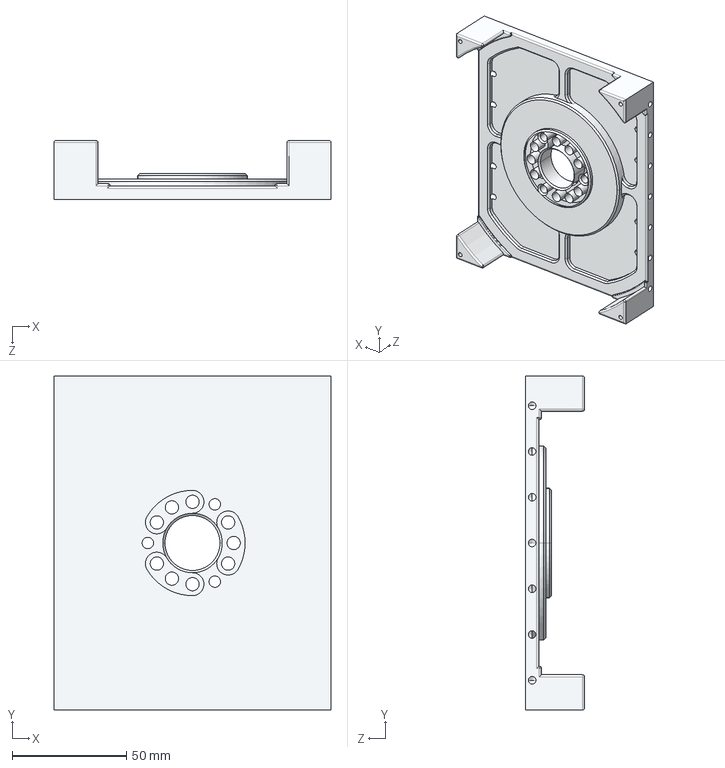
[picture p59: CAD file, 2026-02-06]
atom01_mechnaic/02_Manufacturing/CNC_Machining/Battery_Bottom_Cover.STEP
121.0 x 146.0 x 26.0 mm
