philspins/Atom01_hardware/atom01_mechnaic/01_SW_Project/Lower_Leg_Calibration.SLDPRT

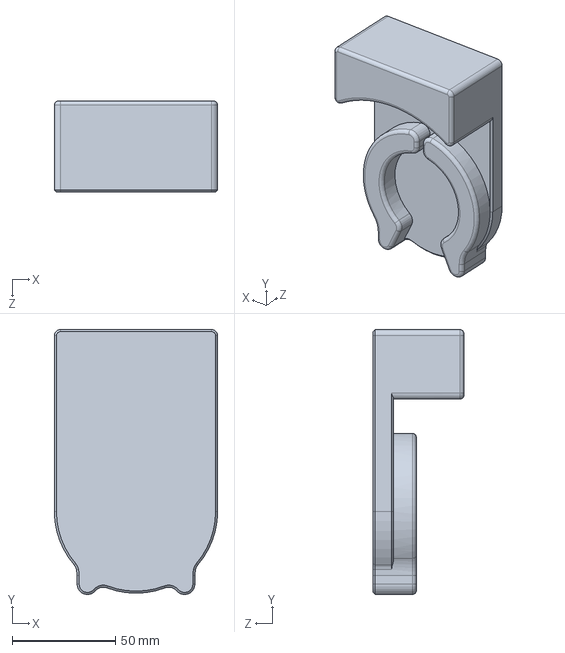
[picture p60: CAD file, 2026-02-06]
atom01_mechnaic/01_SW_Project/Lower_Leg_Calibration.SLDPRT
79.0 x 128.2 x 44.0 mm
