philspins/Atom01_hardware/atom01_mechnaic/02_Manufacturing/CNC_Machining/Shoulder.STEP

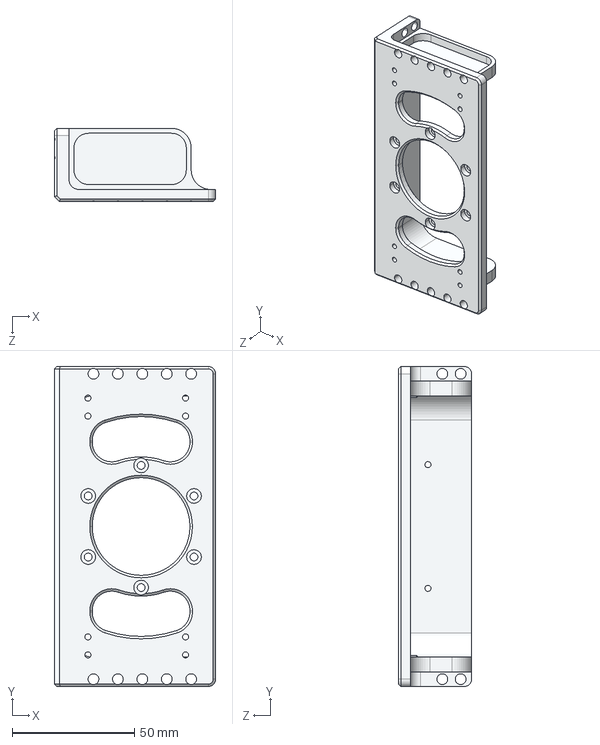
[picture p61: CAD file, 2026-02-06]
atom01_mechnaic/02_Manufacturing/CNC_Machining/Shoulder.STEP
66.0 x 131.0 x 30.0 mm
