philspins/Atom01_hardware/atom01_mechnaic/01_SW_Project/16x40_Cross_Bearing.SLDPRT

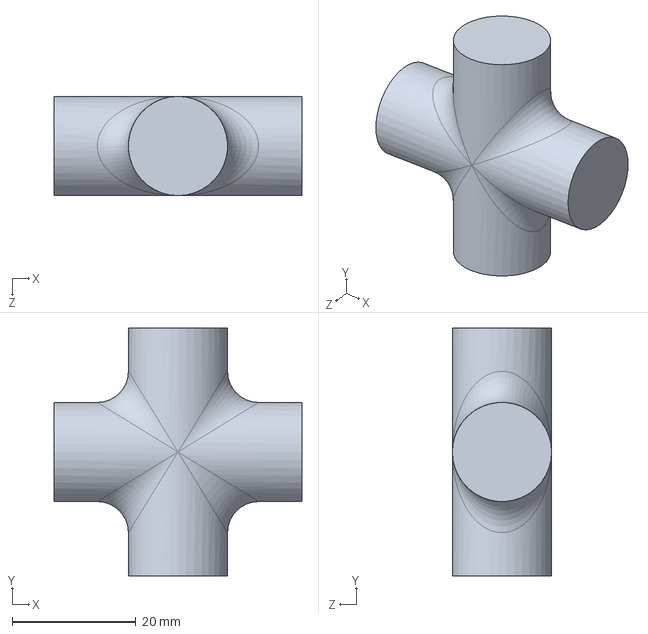
[picture p62: CAD file, 2026-02-06]
atom01_mechnaic/01_SW_Project/16x40_Cross_Bearing.SLDPRT
40.0 x 40.0 x 16.0 mm
