philspins/Atom01_hardware/atom01_mechnaic/02_Manufacturing/CNC_Machining/Foot_Sole_Link.STEP

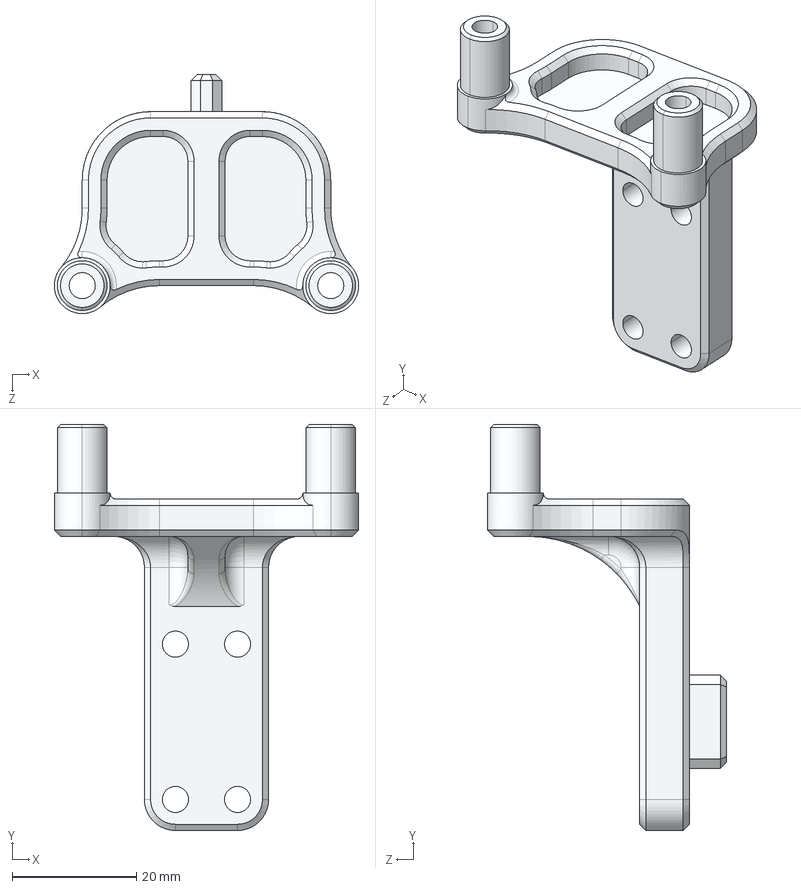
[picture p63: CAD file, 2026-02-06]
atom01_mechnaic/02_Manufacturing/CNC_Machining/Foot_Sole_Link.STEP
49.0 x 65.4 x 38.5 mm
