philspins/Atom01_hardware/atom01_mechnaic/01_SW_Project/DM_4340_rau_3505_motor_3D.SLDPRT

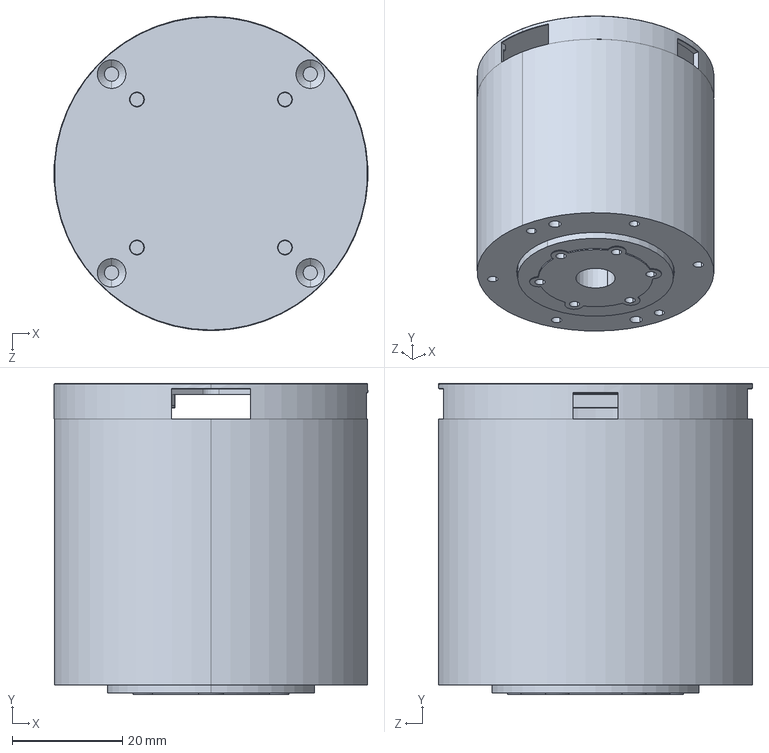
[picture p64: CAD file, 2026-02-06]
atom01_mechnaic/01_SW_Project/DM_4340_rau_3505_motor_3D.SLDPRT
56.9 x 56.5 x 57.0 mm
