philspins/Atom01_hardware/atom01_mechnaic/02_Manufacturing/CNC_Machining/Thigh_Inner_Side.STEP

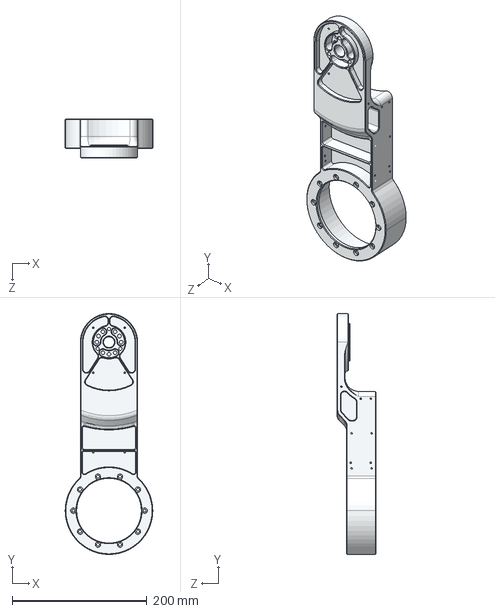
[picture p65: CAD file, 2026-02-06]
atom01_mechnaic/02_Manufacturing/CNC_Machining/Thigh_Inner_Side.STEP
130.0 x 357.5 x 57.7 mm
