philspins/Atom01_hardware/atom01_mechnaic/02_Manufacturing/CNC_Machining/Output_Flange_Link.STEP

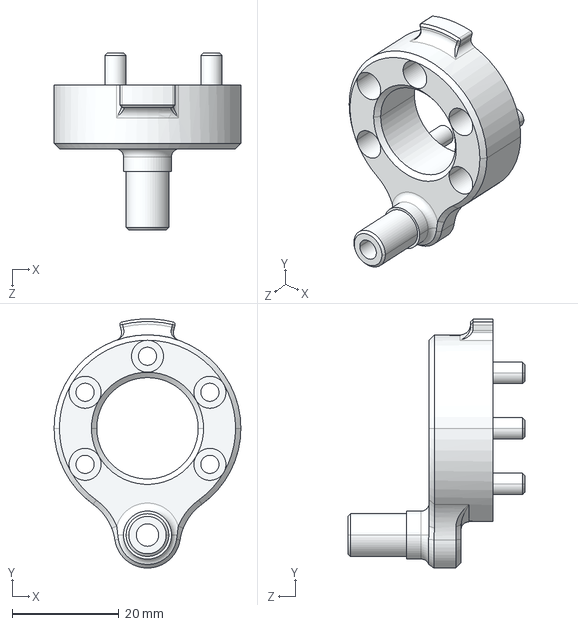
[picture p66: CAD file, 2026-02-06]
atom01_mechnaic/02_Manufacturing/CNC_Machining/Output_Flange_Link.STEP
35.0 x 46.6 x 33.3 mm
