philspins/Atom01_hardware/atom01_mechnaic/01_SW_Project/Column.SLDPRT

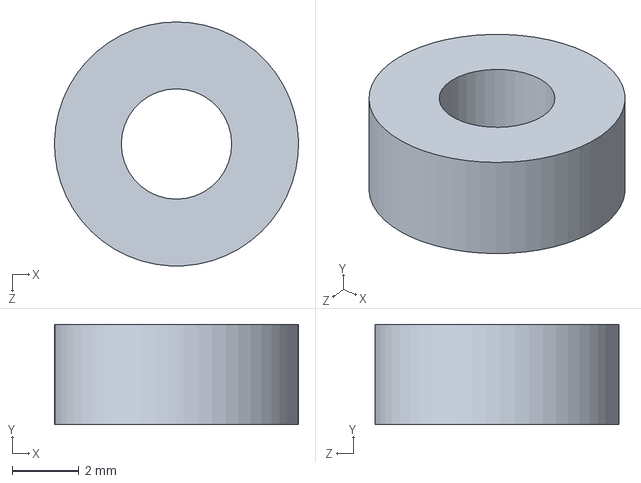
[picture p67: CAD file, 2026-02-06]
atom01_mechnaic/01_SW_Project/Column.SLDPRT
7.30 x 3.00 x 7.30 mm
