philspins/Atom01_hardware/atom01_mechnaic/01_SW_Project/Calibration_Rescue.SLDPRT

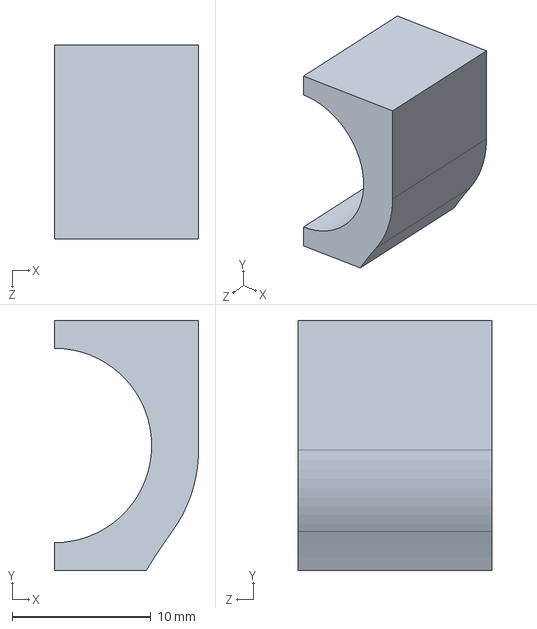
[picture p68: CAD file, 2026-02-06]
atom01_mechnaic/01_SW_Project/Calibration_Rescue.SLDPRT
10.4 x 18.0 x 14.0 mm
