philspins/Atom01_hardware/atom01_mechnaic/01_SW_Project/Mirrored_GB_T_9163-2001[Radial_Spherical_Plain_Bearing_G_Series_8].SLDPRT

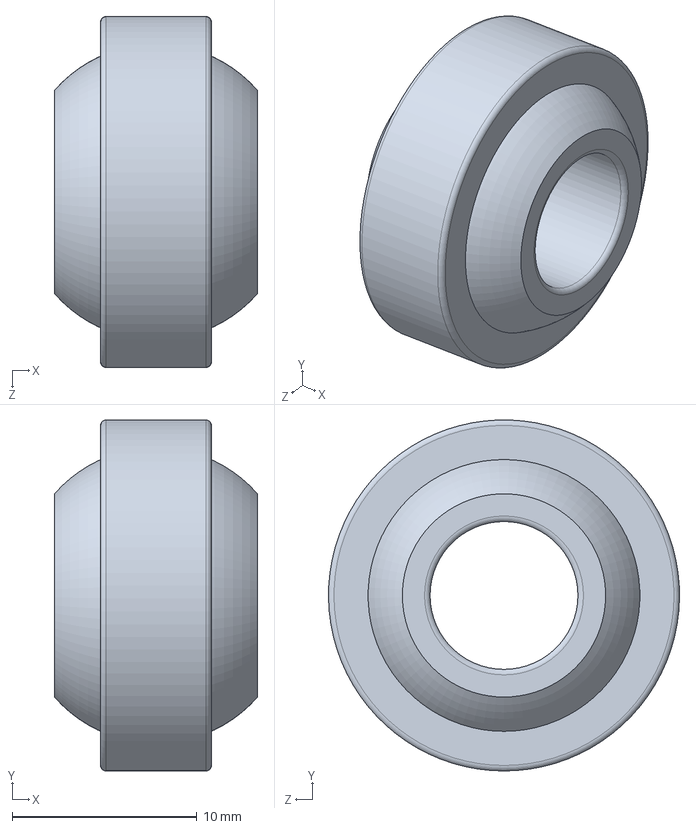
[picture p69: CAD file, 2026-02-06]
atom01_mechnaic/01_SW_Project/Mirrored_GB_T_9163-2001[Radial_Spherical_Plain_Bearing_G_Series_8].SLDPRT
11.0 x 19.0 x 19.0 mm
