philspins/Atom01_hardware/atom01_mechnaic/01_SW_Project/Thigh_Parallel_Calibration.SLDPRT

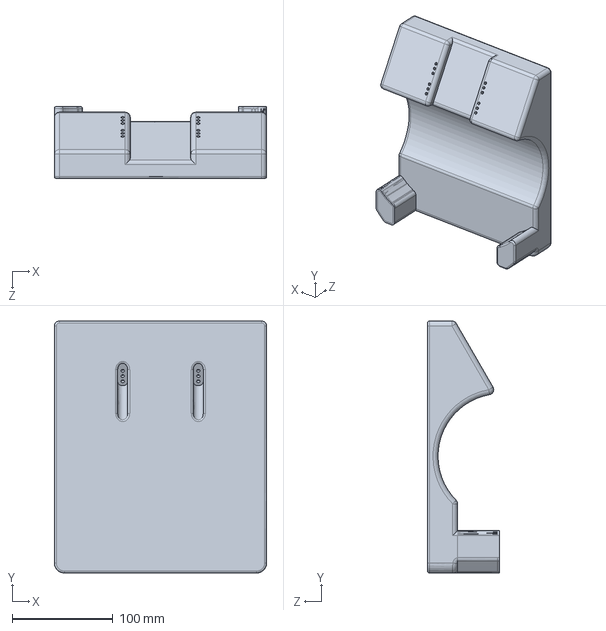
[picture p70: CAD file, 2026-02-06]
atom01_mechnaic/01_SW_Project/Thigh_Parallel_Calibration.SLDPRT
210.7 x 250.0 x 71.5 mm
