philspins/Atom01_hardware/atom01_mechnaic/01_SW_Project/Upper_Arm_Top_Rear.stp

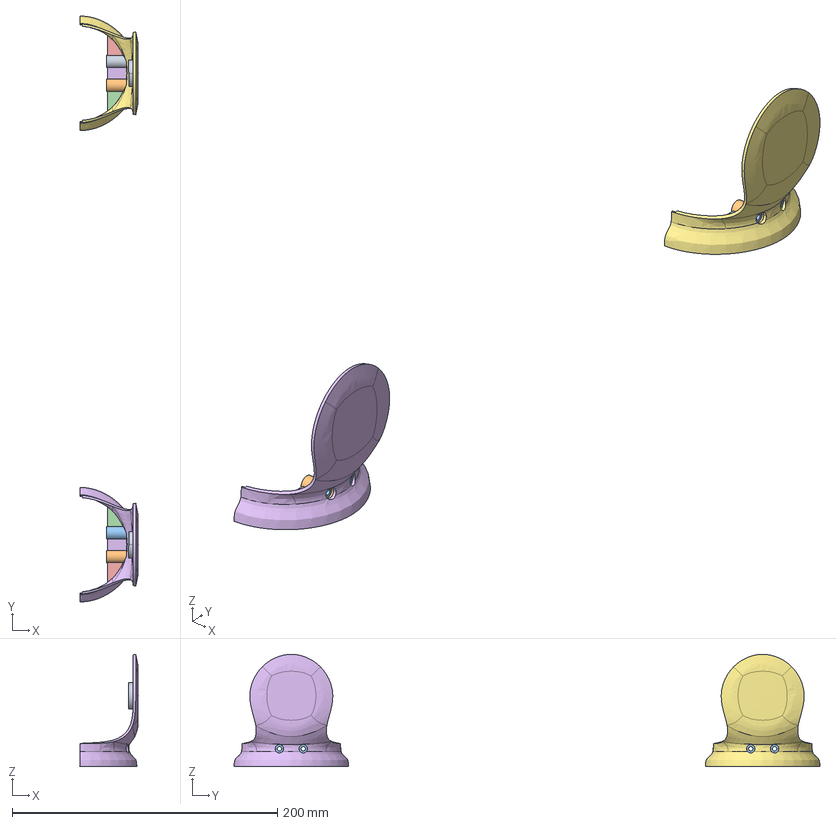
[picture p71: CAD file, 2026-02-06]
atom01_mechnaic/01_SW_Project/Upper_Arm_Top_Rear.stp
44.1 x 442.0 x 84.8 mm
