philspins/Atom01_hardware/atom01_mechnaic/01_SW_Project/Rolling_Bearing.SLDPRT

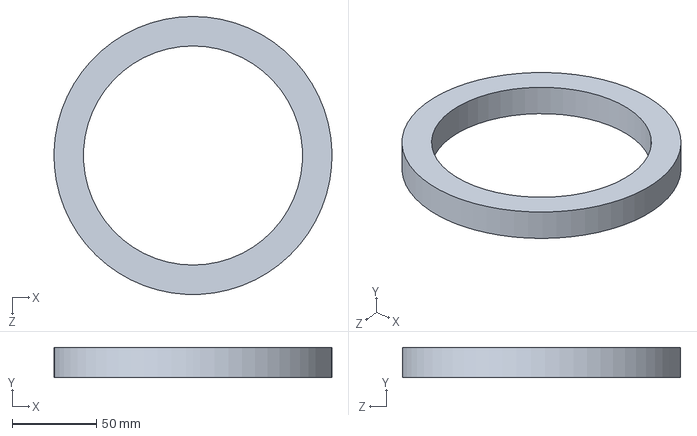
[picture p72: CAD file, 2026-02-06]
atom01_mechnaic/01_SW_Project/Rolling_Bearing.SLDPRT
164.9 x 18.0 x 165.0 mm
