philspins/Atom01_hardware/atom01_mechnaic/01_SW_Project/Battery_Bottom_Cover.STEP

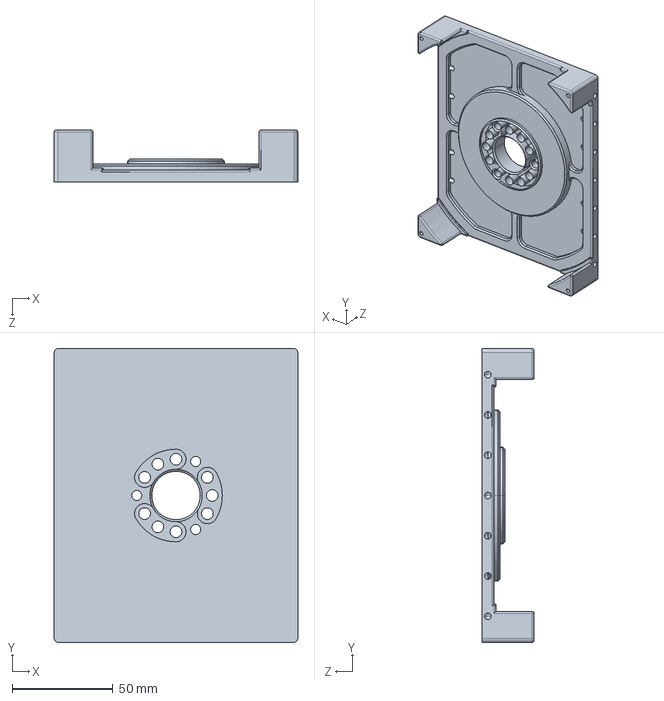
[picture p73: CAD file, 2026-02-06]
atom01_mechnaic/01_SW_Project/Battery_Bottom_Cover.STEP
121.0 x 146.0 x 26.0 mm
