philspins/Atom01_hardware/atom01_mechnaic/01_SW_Project/270x60x70_Battery.SLDPRT

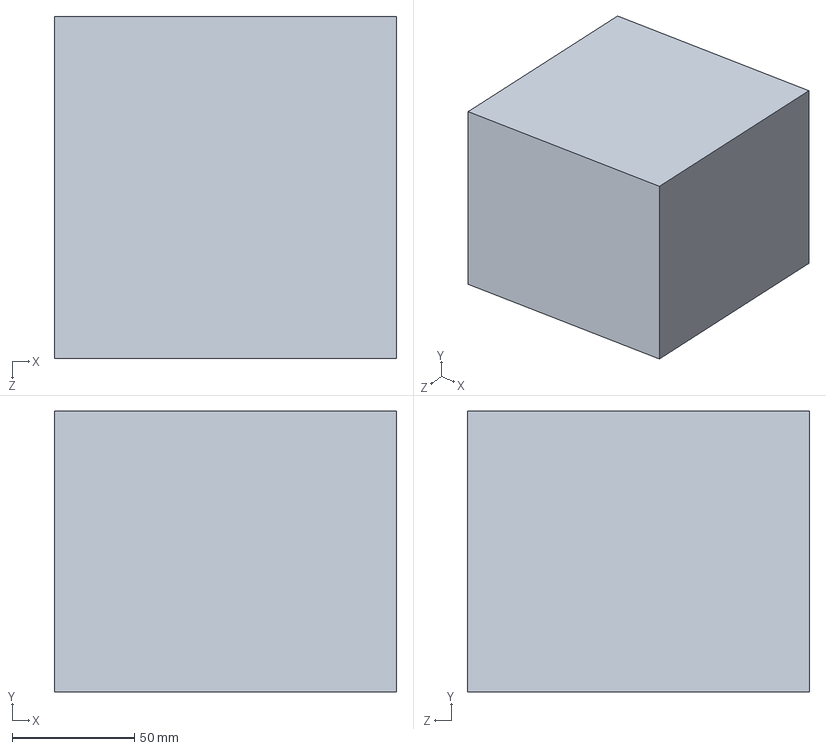
[picture p74: CAD file, 2026-02-06]
atom01_mechnaic/01_SW_Project/270x60x70_Battery.SLDPRT
140.0 x 115.0 x 140.0 mm
