philspins/Atom01_hardware/atom01_mechnaic/01_SW_Project/PCB_Mounting.SLDPRT

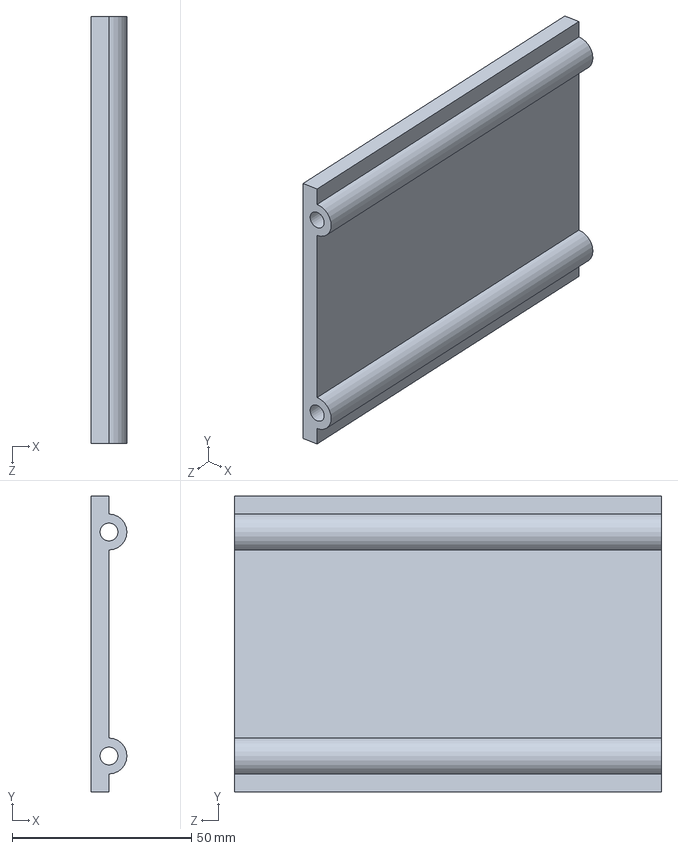
[picture p75: CAD file, 2026-02-06]
atom01_mechnaic/01_SW_Project/PCB_Mounting.SLDPRT
10.0 x 82.4 x 119.0 mm
