philspins/Atom01_hardware/atom01_mechnaic/01_SW_Project/IMU_Contrast.SLDPRT

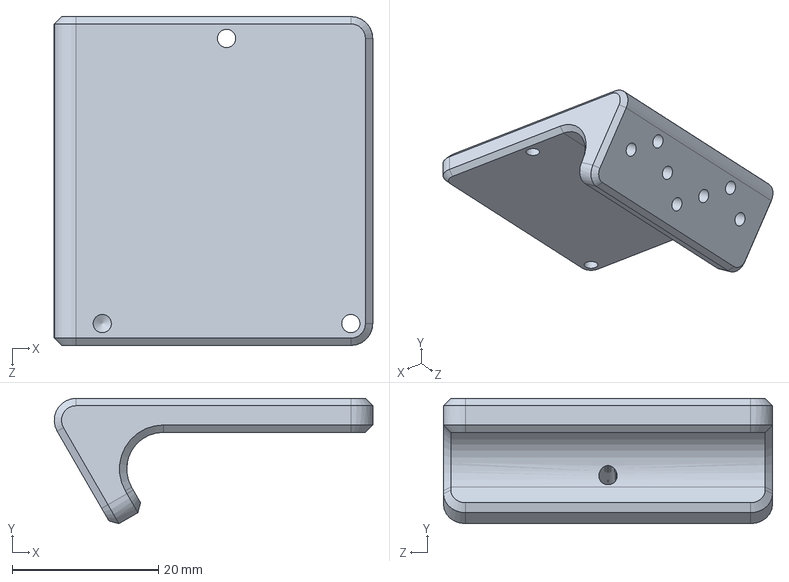
[picture p76: CAD file, 2026-02-06]
atom01_mechnaic/01_SW_Project/IMU_Contrast.SLDPRT
43.6 x 17.1 x 45.0 mm
