philspins/Atom01_hardware/atom01_mechnaic/01_SW_Project/atom_arm_copy_5.STEP

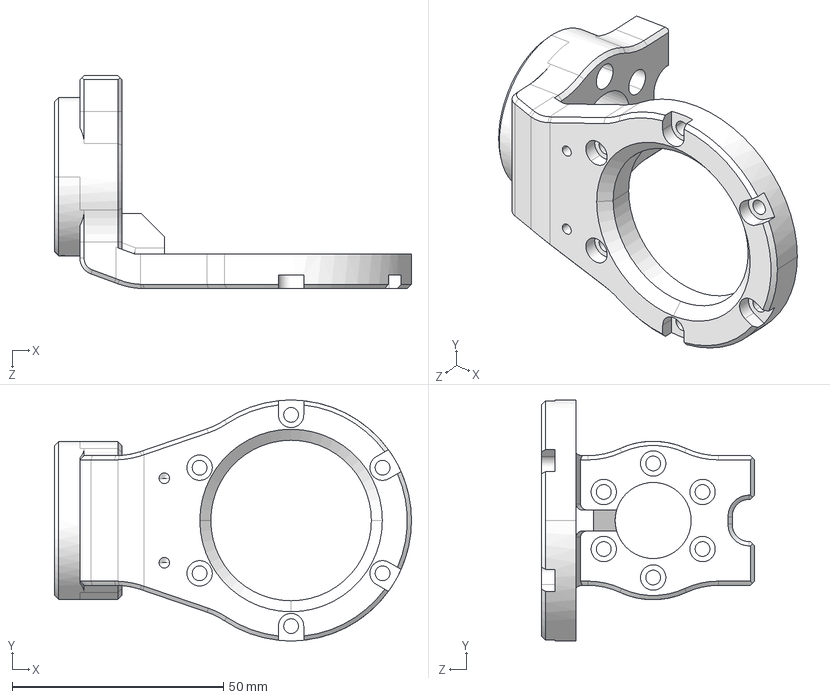
[picture p77: CAD file, 2026-02-06]
atom01_mechnaic/01_SW_Project/atom_arm_copy_5.STEP
84.5 x 57.0 x 50.5 mm
