philspins/Atom01_hardware/atom01_mechnaic/01_SW_Project/atom_arm_copy_2.STEP

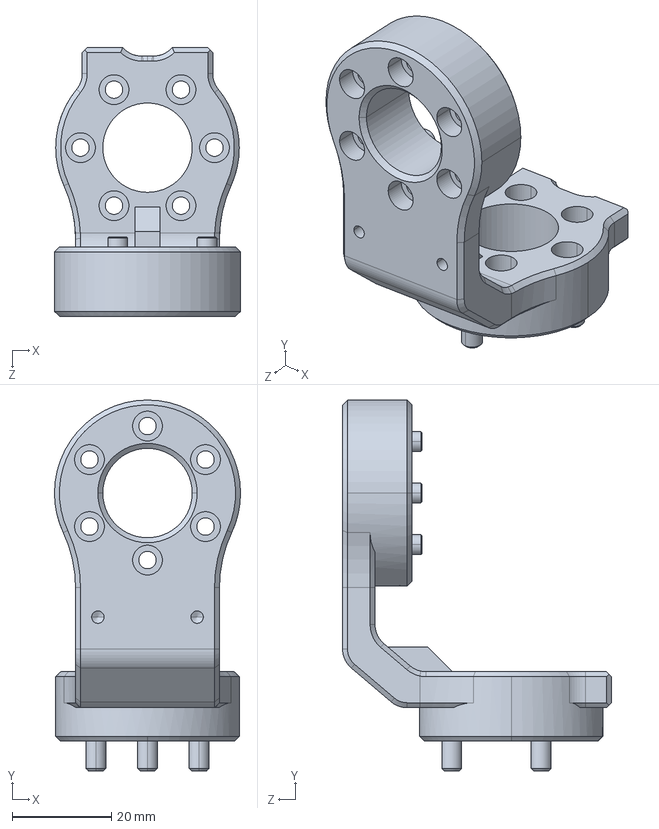
[picture p78: CAD file, 2026-02-06]
atom01_mechnaic/01_SW_Project/atom_arm_copy_2.STEP
37.5 x 74.7 x 54.2 mm
