philspins/Atom01_hardware/atom01_mechnaic/01_SW_Project/IMU_Fixture.SLDPRT

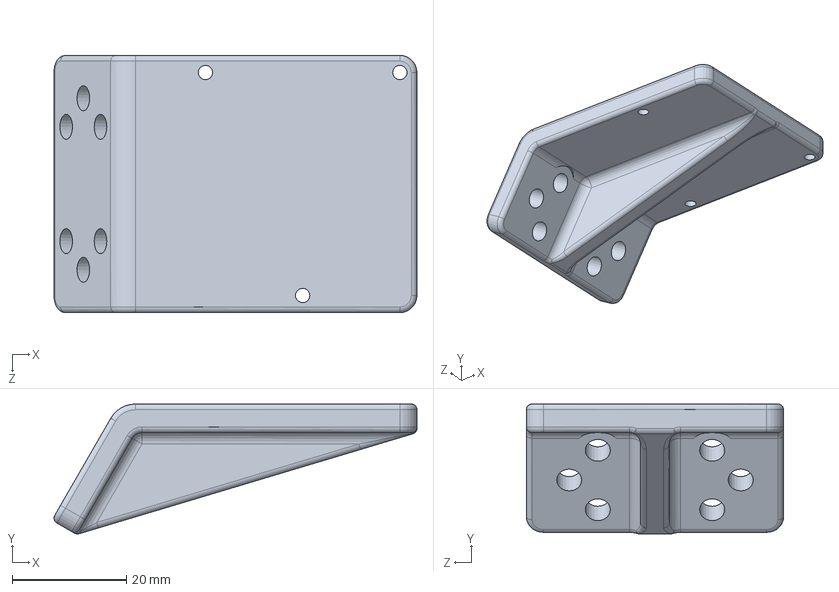
[picture p79: CAD file, 2026-02-06]
atom01_mechnaic/01_SW_Project/IMU_Fixture.SLDPRT
63.5 x 22.7 x 45.0 mm
