philspins/Atom01_hardware/atom01_mechnaic/01_SW_Project/Upper_Arm_Top_Front.stp

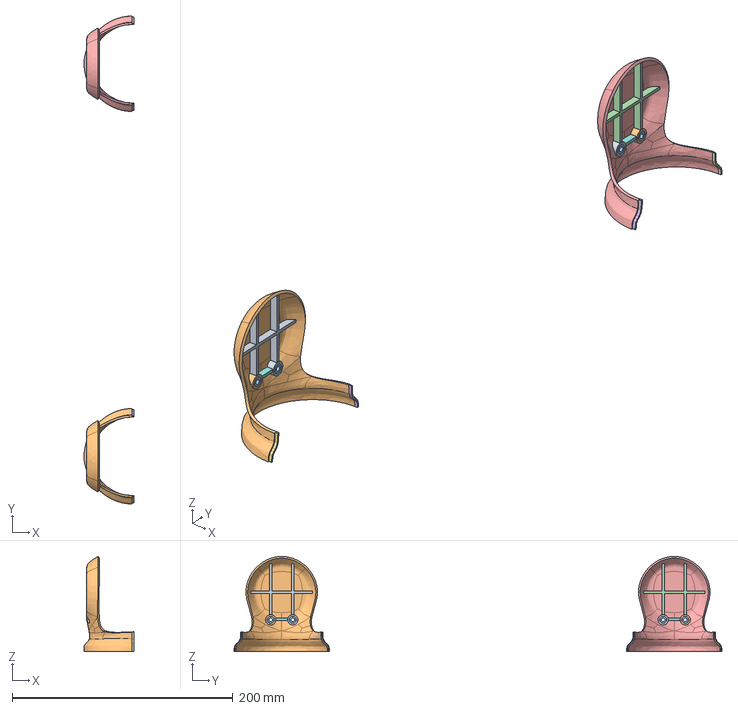
[picture p80: CAD file, 2026-02-06]
atom01_mechnaic/01_SW_Project/Upper_Arm_Top_Front.stp
45.3 x 442.0 x 86.3 mm
