philspins/Atom01_hardware/(list of files, cad)

Other CAD files:
atom01_mechnaic/01_SW_Project/Positioning_Dimensions.SLDASM
atom01_mechnaic/atom-bom/SW模型/外壳修改部件(1)/外壳修改部件/大腿根部结构开孔.stp
atom01_mechnaic/01_SW_Project/01_Calibration_Parts/Shoulder_Mounting_Part_Qty2.STEP
atom01_mechnaic/01_SW_Project/Shell_Modified_Parts_1/Shell_Modified_Parts/Waist_Lower_Part.stp
atom01_mechnaic/atom-bom/SW模型/外壳修改部件(1)/外壳修改部件/胸腔肩部.stp
atom01_mechnaic/01_SW_Project/Scale_1-2_Perimeter_Drawing.DWG
atom01_mechnaic/02_Manufacturing/3D_Printing/Shoulder_Mounting_Part_Qty2.STEP
atom01_mechnaic/02_Manufacturing/CNC_Machining/Chest_Rear_Clamp_Plate.STEP
atom01_mechnaic/02_Manufacturing/CNC_Machining/Universal_Connector.STEP
atom01_mechnaic/02_Manufacturing/CNC_Machining/Lower_Leg_Bearing_Lock.STEP
atom01_mechnaic/01_SW_Project/Foot_Calibration_Part.SLDPRT
atom01_mechnaic/02_Manufacturing/CNC_Machining/Universal_Connector_Enlarged_Hole_Flange.STEP
atom01_mechnaic/01_SW_Project/Universal_Connector.STEP
atom01_mechnaic/01_SW_Project/Mirrored_16x40_Cross_Bearing.SLDPRT
atom01_mechnaic/01_SW_Project/atom_arm_copy_4.STEP
atom01_mechnaic/01_SW_Project/Soft_Rubber_Thigh_Root_Left.SLDPRT
atom01_mechnaic/01_SW_Project/Universal_Connector_Enlarged_Hole_Flange.STEP
atom01_mechnaic/01_SW_Project/Thigh_Inner_Side.STEP
atom01_mechnaic/01_SW_Project/Side_Plate_Cross_Plate.STEP
atom01_mechnaic/01_SW_Project/Lower_Leg_Protection_Cover.SLDPRT
atom01_mechnaic/01_SW_Project/Shoulder.STEP
atom01_mechnaic/01_SW_Project/Waist_Calibration_Part.SLDPRT
atom01_mechnaic/01_SW_Project/Left_Hand.SLDPRT
atom01_mechnaic/01_SW_Project/GB_T_9163-2001[Radial_Spherical_Plain_Bearing_G_Series_8].sldprt
atom01_mechnaic/01_SW_Project/20cm_Foot/20cm_Foot.SLDDRW
atom01_mechnaic/01_SW_Project/20cm_Foot/20cm_Foot.SLDPRT
atom01_mechnaic/01_SW_Project/Ankle_Roll_Connector.SLDPRT
atom01_mechnaic/01_SW_Project/Battery_Bottom_Cover.SLDPRT
atom01_mechnaic/01_SW_Project/Chest_Front_Rear_Clamp_Plate.SLDPRT
atom01_mechnaic/01_SW_Project/Chest_Rear_Clamp_Plate.SLDPRT
atom01_mechnaic/01_SW_Project/Flat_Head_Screw_M3x10.SLDPRT
atom01_mechnaic/01_SW_Project/Flat_Head_Screw_M4x10.SLDPRT
atom01_mechnaic/01_SW_Project/Flat_Head_Screw_M4x12.SLDPRT
atom01_mechnaic/01_SW_Project/Flat_Head_Screw_M4x8.SLDPRT
atom01_mechnaic/01_SW_Project/Flat_Head_Screw_M5x10.SLDPRT
atom01_mechnaic/01_SW_Project/Flat_Head_Screw_M5x16.SLDPRT
atom01_mechnaic/01_SW_Project/Foot_Sole_Link.SLDPRT
atom01_mechnaic/01_SW_Project/Foot_Sole_Plate.SLDPRT
atom01_mechnaic/01_SW_Project/GB_T_6170-2015[Type1_Hex_Nut_M3].SLDPRT
atom01_mechnaic/01_SW_Project/GB_T_6170-2015[Type1_Hex_Nut_M3].step
atom01_mechnaic/01_SW_Project/GB_T_6170-2015[Type1_Hex_Nut_M4].SLDPRT
atom01_mechnaic/01_SW_Project/GB_T_6170-2015[Type1_Hex_Nut_M4].step
atom01_mechnaic/01_SW_Project/GB_T_6170-2015[Type1_Hex_Nut_M6].SLDPRT
atom01_mechnaic/01_SW_Project/GB_T_6170-2015[Type1_Hex_Nut_M6].step
atom01_mechnaic/01_SW_Project/GB_T_70.1-2008[Socket_Head_Cap_Screw_M3x10].SLDPRT
atom01_mechnaic/01_SW_Project/GB_T_70.1-2008[Socket_Head_Cap_Screw_M3x10].step
atom01_mechnaic/01_SW_Project/GB_T_70.1-2008[Socket_Head_Cap_Screw_M3x12].SLDPRT
atom01_mechnaic/01_SW_Project/GB_T_70.1-2008[Socket_Head_Cap_Screw_M3x12].step
atom01_mechnaic/01_SW_Project/GB_T_70.1-2008[Socket_Head_Cap_Screw_M3x16].SLDPRT
atom01_mechnaic/01_SW_Project/GB_T_70.1-2008[Socket_Head_Cap_Screw_M3x16].step
atom01_mechnaic/01_SW_Project/GB_T_70.1-2008[Socket_Head_Cap_Screw_M3x6].SLDPRT
atom01_mechnaic/01_SW_Project/GB_T_70.1-2008[Socket_Head_Cap_Screw_M3x6].step
atom01_mechnaic/01_SW_Project/GB_T_70.1-2008[Socket_Head_Cap_Screw_M3x8].SLDPRT
atom01_mechnaic/01_SW_Project/GB_T_70.1-2008[Socket_Head_Cap_Screw_M3x8].step
atom01_mechnaic/01_SW_Project/GB_T_70.1-2008[Socket_Head_Cap_Screw_M4x10].step
atom01_mechnaic/01_SW_Project/GB_T_70.1-2008[Socket_Head_Cap_Screw_M4x12].SLDPRT
atom01_mechnaic/01_SW_Project/GB_T_70.1-2008[Socket_Head_Cap_Screw_M4x12].step
atom01_mechnaic/01_SW_Project/GB_T_70.1-2008[Socket_Head_Cap_Screw_M4x14].SLDPRT
atom01_mechnaic/01_SW_Project/GB_T_70.1-2008[Socket_Head_Cap_Screw_M4x16].step
atom01_mechnaic/01_SW_Project/GB_T_70.1-2008[Socket_Head_Cap_Screw_M4x8].SLDPRT
atom01_mechnaic/01_SW_Project/GB_T_70.1-2008[Socket_Head_Cap_Screw_M4x8].step
atom01_mechnaic/01_SW_Project/GB_T_70.1-2008[Socket_Head_Cap_Screw_M5x10].SLDPRT
atom01_mechnaic/01_SW_Project/GB_T_70.1-2008[Socket_Head_Cap_Screw_M5x10].step
atom01_mechnaic/01_SW_Project/GB_T_70.1-2008[Socket_Head_Cap_Screw_M5x12].SLDPRT
atom01_mechnaic/01_SW_Project/GB_T_70.1-2008[Socket_Head_Cap_Screw_M6x20].SLDPRT
atom01_mechnaic/01_SW_Project/GB_T_70.1-2008[Socket_Head_Cap_Screw_M6x20].step
atom01_mechnaic/01_SW_Project/Handle.SLDPRT
atom01_mechnaic/01_SW_Project/Hip_Clamp_Plate.SLDPRT
atom01_mechnaic/01_SW_Project/Hip_Joint_Mounting.SLDPRT
atom01_mechnaic/01_SW_Project/Limit_Pin.SLDPRT
atom01_mechnaic/01_SW_Project/Long_Link.SLDPRT
atom01_mechnaic/01_SW_Project/Lower_Leg.SLDPRT
atom01_mechnaic/01_SW_Project/Lower_Leg_Bearing_Lock.SLDPRT
atom01_mechnaic/01_SW_Project/Output_Flange_Link.SLDPRT
atom01_mechnaic/01_SW_Project/PCB_Carrier_Board.SLDPRT
atom01_mechnaic/01_SW_Project/Rubber_Foot_Sole/Rubber_Foot_Sole.SLDPRT
atom01_mechnaic/01_SW_Project/Short_Link.SLDPRT
atom01_mechnaic/01_SW_Project/Shoulder.SLDPRT
atom01_mechnaic/01_SW_Project/Side_Plate_Cross_Plate.SLDPRT
atom01_mechnaic/01_SW_Project/Skeleton_and_Skeleton_Screws.SLDASM
atom01_mechnaic/01_SW_Project/Thigh_Inner_Side.SLDPRT
atom01_mechnaic/01_SW_Project/Universal_Connector.SLDPRT
atom01_mechnaic/01_SW_Project/Universal_Connector_Enlarged_Hole_Flange.SLDPRT
atom01_mechnaic/01_SW_Project/Waist_Support.SLDPRT
atom01_mechnaic/01_SW_Project/atom_arm_copy_1.SLDPRT
atom01_mechnaic/01_SW_Project/atom_arm_copy_2.SLDPRT
atom01_mechnaic/01_SW_Project/atom_arm_copy_3.SLDPRT
atom01_mechnaic/01_SW_Project/atom_arm_copy_4.SLDPRT
atom01_mechnaic/01_SW_Project/atom_arm_copy_5.SLDPRT
atom01_mechnaic/02_Manufacturing/3D_Printing/PCB_Carrier_Board.SLDPRT
atom01_mechnaic/atom-bom/图纸&STEP模型/IMU反差.SLDDRW
atom01_mechnaic/atom-bom/图纸&STEP模型/atom手臂 - 副本 (1).SLDDRW
atom01_mechnaic/atom-bom/图纸&STEP模型/atom手臂 - 副本 (2).SLDDRW
atom01_mechnaic/atom-bom/图纸&STEP模型/atom手臂 - 副本 (3).SLDDRW
atom01_mechnaic/atom-bom/图纸&STEP模型/atom手臂 - 副本 (4).SLDDRW
atom01_mechnaic/atom-bom/图纸&STEP模型/大腿内侧.SLDDRW
atom01_mechnaic/atom-bom/图纸&STEP模型/小腿.SLDDRW
atom01_mechnaic/atom-bom/图纸&STEP模型/小腿轴承锁.SLDDRW
atom01_mechnaic/atom-bom/图纸&STEP模型/电池底盖.SLDDRW
atom01_mechnaic/atom-bom/图纸&STEP模型/短连杆.SLDDRW
atom01_mechnaic/atom-bom/图纸&STEP模型/肩膀.SLDDRW
atom01_mechnaic/atom-bom/图纸&STEP模型/胸腔前后夹板.SLDDRW
atom01_mechnaic/atom-bom/图纸&STEP模型/脚底板.SLDDRW
atom01_mechnaic/atom-bom/图纸&STEP模型/脚底连杆.SLDDRW
atom01_mechnaic/atom-bom/图纸&STEP模型/脚踝横滚连接件.SLDDRW
atom01_mechnaic/atom-bom/图纸&STEP模型/腰部支撑.SLDDRW
atom01_mechnaic/atom-bom/图纸&STEP模型/输出法兰连杆.SLDDRW
atom01_mechnaic/atom-bom/图纸&STEP模型/通用连接件.SLDDRW
atom01_mechnaic/atom-bom/图纸&STEP模型/通用连接件扩孔法兰.SLDDRW
atom01_mechnaic/atom-bom/图纸&STEP模型/长连杆.SLDDRW
atom01_mechnaic/atom-bom/图纸&STEP模型/限位销.SLDDRW
atom01_mechnaic/atom-bom/图纸&STEP模型/髋关节固定.SLDDRW
atom01_mechnaic/atom-bom/图纸&STEP模型/髋夹板.SLDDRW
