philspins/Atom01_hardware/atom01_mechnaic/02_Manufacturing/CNC_Machining/20cm_Foot_ENG.pdf

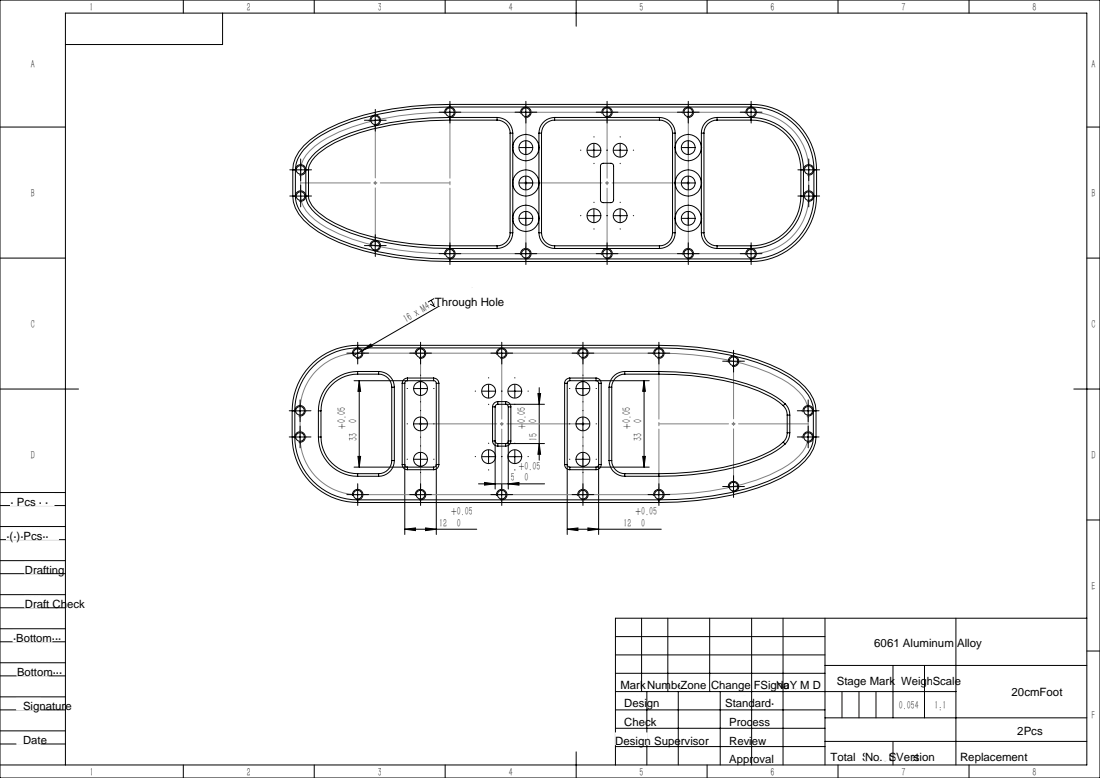
[picture p186: page 1]
16 x M4 完全贯穿; 更改文件号; Through Hole; MarkNumberZone; Change File No. Signature Y M D; Stage Mark; Total; Sheet No.; Sheet; Draft Check; · Pcs · ·; Design Supervisor; 6061 Aluminum Alloy
