philspins/Atom01_hardware/atom01_mechnaic/02_Manufacturing/CNC_Machining/Chest_Front_Rear_Clamp_Plate_ENG.pdf

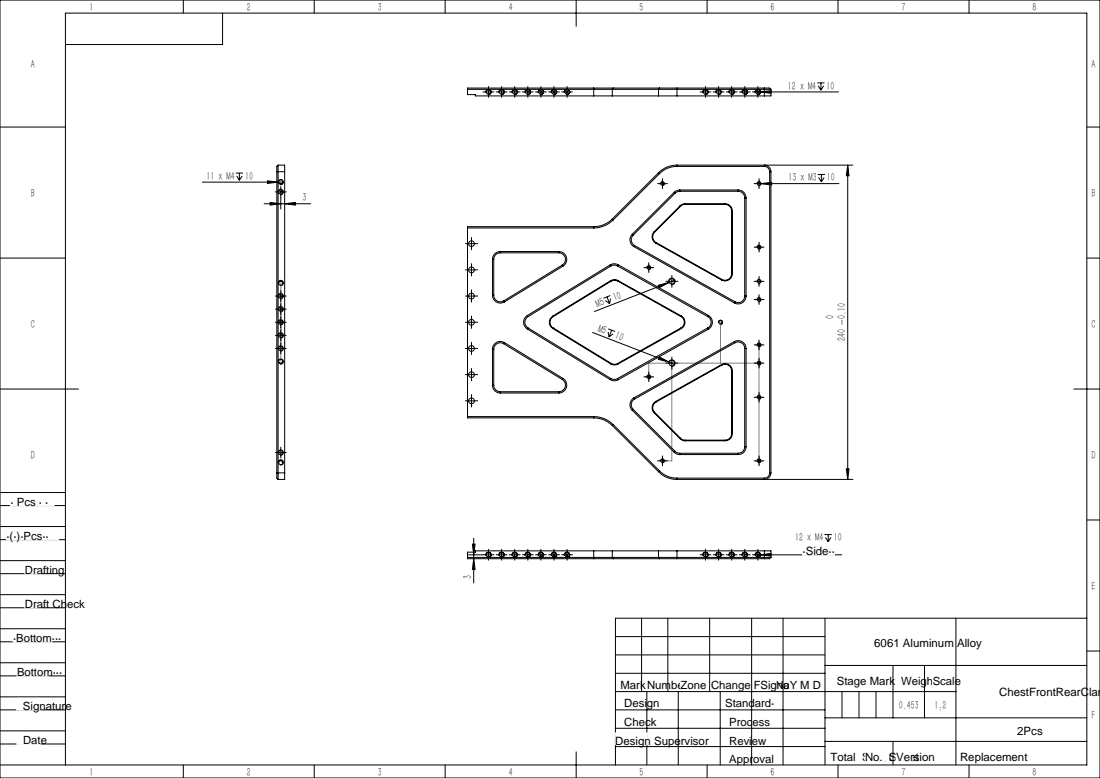
[picture p187: page 1]
更改文件号; MarkNumberZone; Change File No. Signature Y M D; Stage Mark; Total; Sheet No.; Sheet; Draft Check; · Pcs · ·; Design Supervisor; ChestFrontRearClamp Plate; 6061 Aluminum Alloy
