philspins/Atom01_hardware/atom01_mechnaic/02_Manufacturing/CNC_Machining/Chest_Rear_Clamp_Plate_ENG.pdf

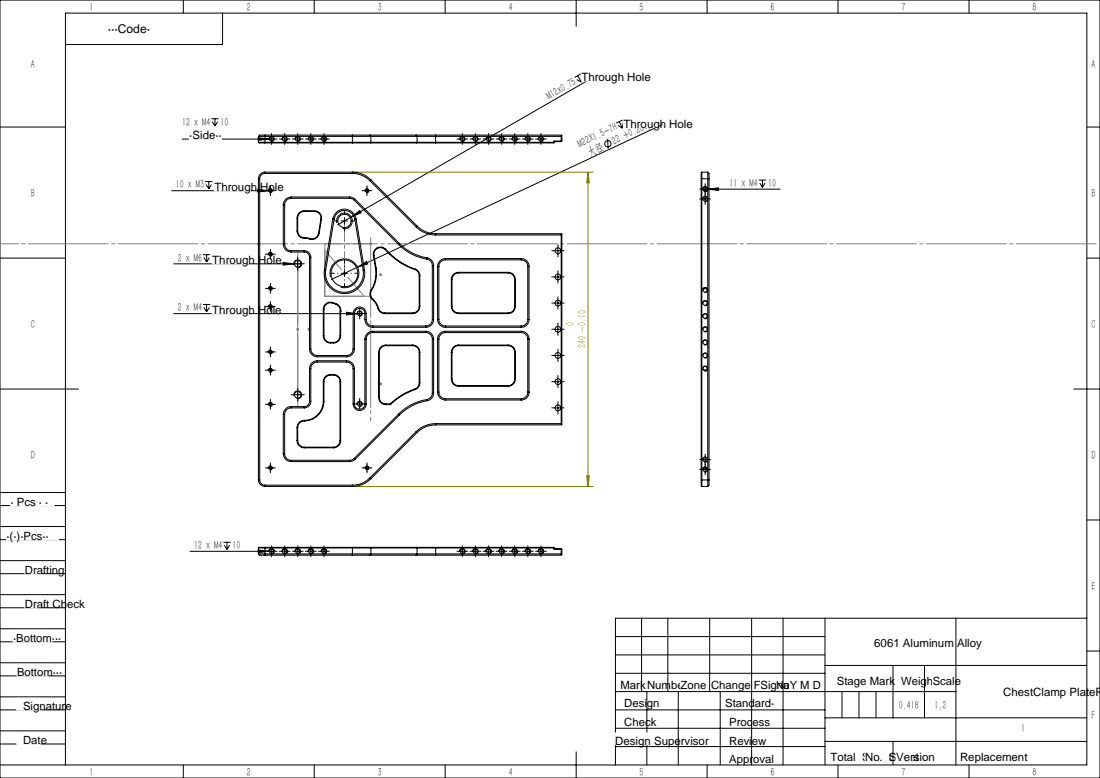
[picture p188: page 1]
完全贯穿; M22X1.5-7H 完全贯穿 大径 22 +0.280/0; M12x0.75 完全贯穿 240; 更改文件号; Through Hole; MarkNumberZone; Change File No. Signature Y M D; Stage Mark; Total; Sheet No.; Sheet; Draft Check; · Pcs · ·; Design Supervisor; ChestClamp PlateRear; 6061 Aluminum Alloy
