philspins/Atom01_hardware/atom01_mechnaic/02_Manufacturing/CNC_Machining/IMU_Carrier_Board_ENG.pdf

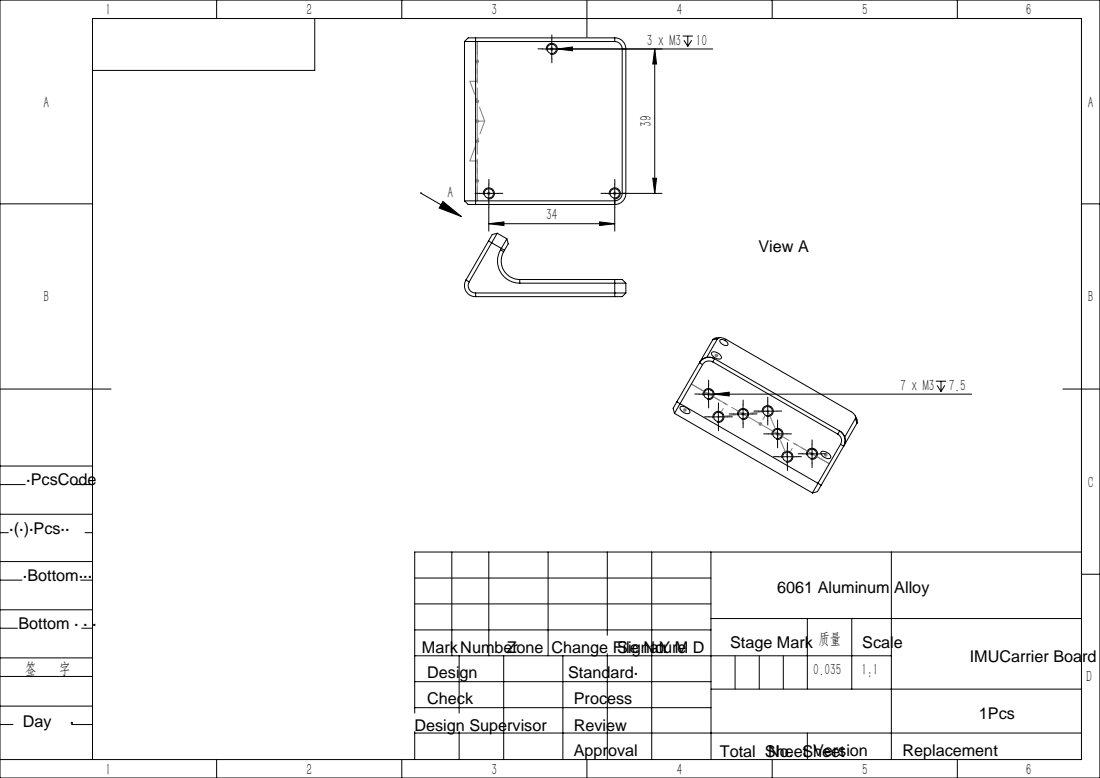
[picture p189: page 1]
更改文件号; View A; Total; Sheet No.; Sheet; Stage Mark; Design Supervisor; Mark NumberZone; Change File No. Signature Y M D; Bottom · · ·; 6061 Aluminum Alloy; IMUCarrier Board
