philspins/Atom01_hardware/(commit log)

2025-05-23 bom表不含线缆，更新了零件及工程图
    [BOM表（不含线缆）.xlsx, IMU反差.SLDDRW, atom手臂 - 副本 (1).SLDDRW, atom手臂 - 副本 (2).SLDDRW, atom手臂 - 副本 (3).SLDDRW, atom手臂 - 副本 (4).SLDDRW, 大腿内侧.SLDDRW, 大腿根部结构开孔.stp]
2026-02-06 translating to english
    completed:
    - file names
    - step files
    - stl files
    - csv files
    in progress:
    - pdf files
    - pptx files
    [16x40_Cross_Bearing.SLDPRT, 16x40十字轴承.SLDPRT, 20cm_Foot.SLDDRW, 20cm_Foot.SLDPRT, 20cm_Foot.STEP, 20cm脚.SLDDRW, 20cm脚.SLDPRT, 20cm脚.STEP]
