philspins/Atom01_hardware/(notices)

Notices in the files:
atom01_mechnaic/README_cn.md:
License: MIT
