philspins/Atom01_hardware/atom01_mechnaic/02_Manufacturing/CNC_Machining/Short_Link.STEP

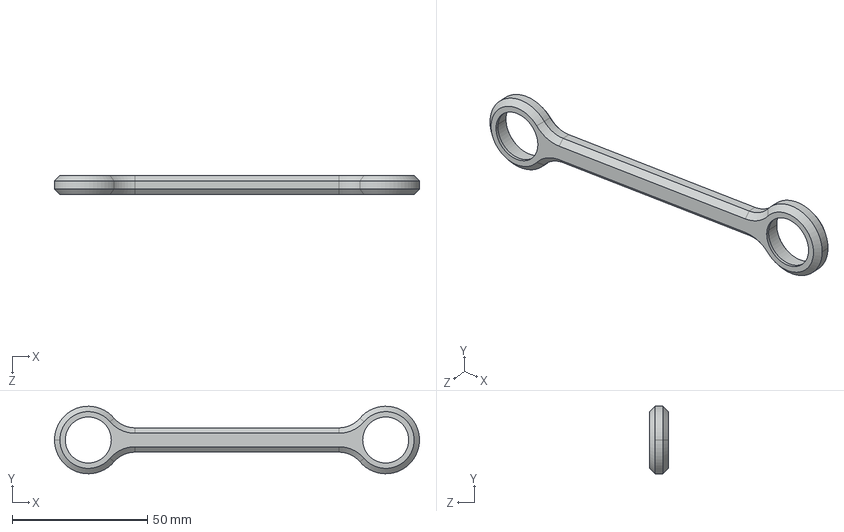
[picture p1: CAD file, 2026-02-06]
atom01_mechnaic/02_Manufacturing/CNC_Machining/Short_Link.STEP
135.0 x 25.0 x 7.00 mm
