philspins/Atom01_hardware/atom01_mechnaic/02_Manufacturing/CNC_Machining/Lower_Leg_Bearing_Lock.pdf

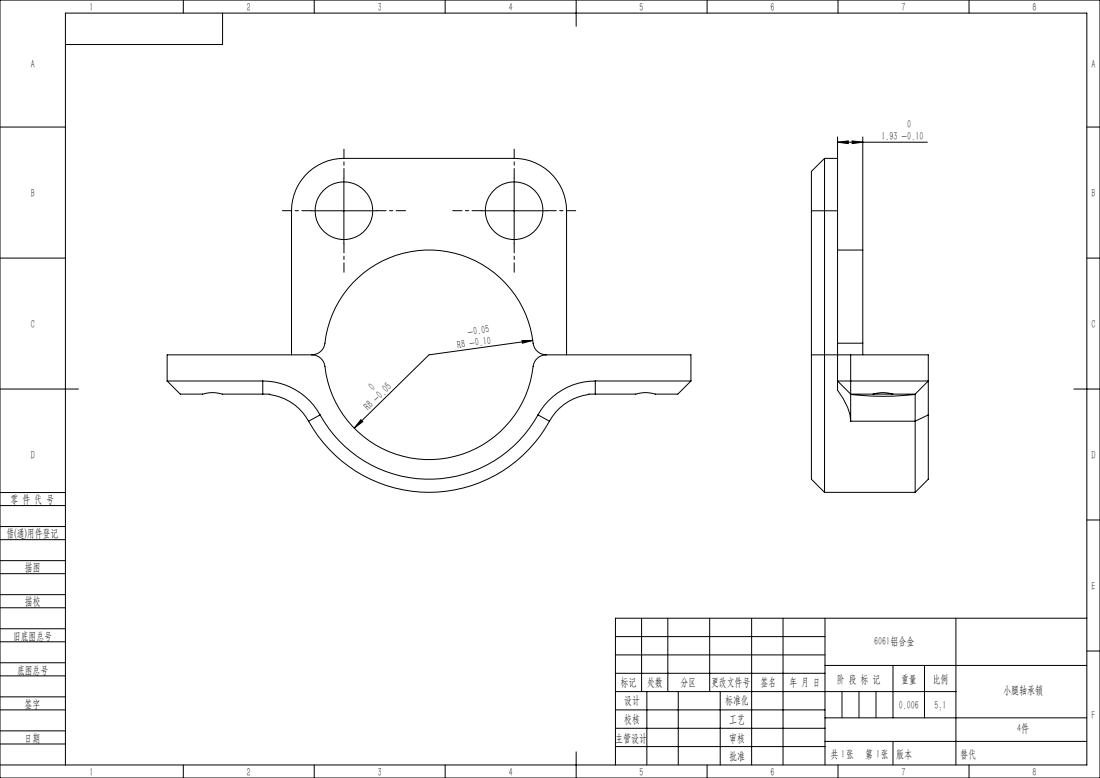
[picture p1: page 1]

6061铝合金

阶 段 标 记 | 重量 | 比例 | 小腿轴承锁

标记 | 处数 | 分区 | 更改文件号 | 签名 | 年 月 日
设计 | | | 标准化 | | | | | 0.006 | 5:1
校核 | | | 工艺
主管设计 | | | 审核
